aeae1/Rock-Saw-Water-Control/docs/hardware-audit-2026-10-04.md

# Electrical audit and revised schematic

Revision C · 4 October 2026 · **Engineering review complete; hardware release on hold**

[Printable schematic and audit](assets/hardware/water-controller-audit-rev-c.pdf) · [Connection schedule](../hardware/rev-c/connections.csv) · [Machine-readable netlist](../hardware/rev-c/netlist.json) · [Parts schedule](../hardware/rev-c/bom.csv)

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

## Release decision

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

## Corrections made

1. Replaced the unspecified four-channel input board with two documented SparkFun BOB-09118 two-channel boards, each operated with a **5 V output-side supply**. Each used input receives its own external 1 kohm series resistor; the board's original 220-ohm input resistor alone is inappropriate for a raw 12 V signal.
2. Separated the HSD boards' 12 V load terminals from their 5 V logic terminals. Documented the reversed orientation of their two supply connectors and the reversal between schematic OUT1..OUT8 names and printed channel 7..0 labels.
3. Specified one effective I2C pull-up pair: the DFR1229's onboard 4.7 kohm resistors. All six HSD pull-up jumpers remain open. The I2C bus runs at 100 kHz inside the enclosure.
4. Retained twenty independently switched lamp-positive leads. One PCA9685 cannot directly drive these twenty 12 V loads. Lamp negatives share the wired supply return.
5. Added a series resistor, filter capacitor and open-wire bias to the position ADC input. SEN0262 is an analog receiver, not an I2C peripheral; no parallel 250-ohm resistor is added to its input.
6. Explicitly showed that the DFR1229 output return and its logic ground are internally common. The selected non-isolated architecture therefore joins valve white and black at the system return, subject to H4.
7. Added a proposed valve inhibit branch on HSD3 channel 4, supervised by a local SW8B watchdog. A small relay disconnects both signal positives when actuator power is removed. The new relay regulator is separate from the Nano's 5 V rail.
8. Added two defined temperature sensors and reused HSD voltage/current measurements to support previously unspecified diagnostics. Actual thresholds remain subject to characterization.
9. Specified the meter's two pull-ups, both signal wires and actual pin assignments. Removed an assumed static error-level interpretation: the meter reports errors by toggling its error output.
10. Identified a command-driver error-reporting defect: the reviewed DFRobot library discards ordinary I2C write status. A checked driver is a release requirement.

## Exact design basis

| Reference | Part / specification | Role |
| :--- | :--- | :--- |
| U1 | Genuine Arduino Nano Every ABX00028 | 5 V controller; machine supply to VIN only |
| HSD1-3 | Serial Wombat PCB0046 HSD, public V2 | Twenty lamp channels; one supervised valve-power channel |
| U2 | DFRobot DFR1229 / GP8600 | 0-20 mA capable DAC, operated only in the 4-20 mA valve range |
| U3 | DFRobot SEN0262 | 0-25 mA to 0-3 V feedback receiver |
| O1, O2 | SparkFun BOB-09118, v1.2 circuit | Two channels each; three used |
| V1 | U.S. Solid USS-MSV50030 | 1/2-inch SS304, 9-24 V, five-wire proportional ball valve |
| FM1 | ScioSense UFM-02-03NP4 | 3/8-inch NPS, four-wire pulse variant; confirm exact order suffix |
| L1-10 | Nilight TL-248BW or electrically verified equivalent | Common black negative, separate blue and white 12 V positive leads |
| K1 | Panasonic TQ2-5V, single-side-stable, standard through-hole | DPDT signal disconnect; not a latching or MBB variant |
| U4 | ST L7805ABV, TO-220 | Dedicated relay-coil 5 V regulator; not connected to logic 5 V |
| TS1, TS2 | Analog Devices / Maxim DS18B20+, TO-92 | Enclosure and actuator-region temperature, externally powered |

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

## Power and grounding

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

The Nano Every uses an MPM3610 switching regulator. Its 5 V header supplies U2, U3, the three HSD logic VDD terminals, O1/O2 HV terminals, the meter, and the two temperature sensors. No lamp or actuator is powered from this rail. Measure total peripheral current and regulator temperature; the IC's headline current capability is not proof of the assembled board's enclosed capacity.

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

## G/H/J input circuit

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

## I2C and lamp drivers

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

## Valve command, feedback and inhibit

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

### Independent timeout proposal

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

## Flow meter

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

## Temperature circuit and enclosure

TS1 and TS2 are normal three-wire DS18B20 sensors: pin 1 GND, pin 2 DQ, pin 3 VDD. For the selected TO-92 package, the flat marked face points toward the observer and the leads point down. Both VDD pins receive 5 V. Both DQ pins share Nano D7 and R10 = 4.7 kohm to 5 V. C3/C6 = 100 nF go across each sensor's supply locally. Do not use parasite power. Record each sensor's unique ROM ID and location; identify a replacement deliberately instead of assigning locations by discovery order.

TS1 measures representative air inside the enclosure; TS2 measures the shaded actuator region. Neither measures the motor winding directly. Protect the external sensor termination in a sealed, strain-relieved probe assembly; bare TO-92 leads are not an outdoor connector. Bound cable length and validate the 1-Wire bus in the installed arrangement. Use CRC-checked reads and nonblocking conversion; a 12-bit conversion can take 750 ms. Reject uncompleted power-on readings, including the initial 85 C value; sensor loss must not look like a safe cold temperature.

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

## Diagnostic coverage and firmware requirements

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

**Avoid a recovery deadlock:** K1 deliberately disconnects feedback when valve power is inhibited. Zero feedback during that state is expected; it is not proof of a repaired or newly broken sensor. Before a recovery attempt, verify independently observable conditions (supply, bus, temperature, valid input states and corrected wiring/obstruction). Treat actuator-dependent checks as pending requalification, not already healthy. A fresh acknowledgement may authorize one supervised closing attempt with the DAC initialized to 4 mA before enabling power. Keep the fault history/latch until powered feedback, current and closure/flow checks pass. Apply characterized startup-settle and motion deadlines; a failed attempt immediately inhibits drive again and requires a new deliberate acknowledgement after correction. Do not wait for powered feedback before supplying its power, and do not clear the fault simply because power removal made its current zero. The simulator's injected-cause controls stand in for these physical checks; this sequence still needs firmware and hardware testing.

### Updated fault response policy (5 October)

The simulator and firmware contract now distinguish operator/settings faults (6, 7, 10) from movement-inhibiting faults (1–5, 8, 9). With independent actuator supervision healthy, operator faults retain valve power and issue a closed command while fault codes remain visible. A movement-inhibiting latch always wins, including after cause removal. Do not drop K1 solely because an operator code latched before the valve has closed; do drop the inhibit path on unsafe actuator conditions or watchdog expiry. Closing deadlines must survive new operator faults and acknowledgement without restarting. Reset makes no additional movement after confirmed closure, otherwise it authorizes/finishes bounded recovery and leaves water OFF. This policy changes software requirements only; the relay/sensor circuit remains unqualified and requires the bench checks described here.

### Does the Arduino log faults?

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

For the base hardware, use a bounded RAM event ring for detailed recent diagnostics, plus a small redundant EEPROM record for the most recent fault/reset summary. One possible allocation remains two 112-byte calibration/settings slots and two 16-byte diagnostic slots, totaling 256 bytes. A 16-byte diagnostic record can contain commit/schema bytes, a 16-bit sequence, 16-bit fault mask, 32-bit uptime, quantized target/position, mode/reset flags and CRC16. It cannot also hold a full curve, timestamps, voltage, current, temperature and many past events. This is a specification, not implemented storage code.

Record fault onset, added/cleared causes, acknowledgement, watchdog/brownout reset and calibration completion; coalesce repeated identical failures. Detailed RAM events should include code/subcode, uptime, raw controls, mode, requested target, measured position, supply, branch current, temperatures, flow validity and last bus error. Do not log every pulse or animation frame. Save only state changes with wear-aware transactional writes; retain the last valid record after an interrupted write. A sudden total power loss may prevent recording the final event, so report the next boot's reset cause as well.

No real-time clock is present. Records can contain uptime and sequence/boot context, but not reliable calendar dates while disconnected. A USB service command can export and inspect records later without clearing latches or moving the valve. Keep serial output nonblocking; a disconnected laptop must not stall control. For a substantial history that survives power removal, add a separately specified nonvolatile memory such as FRAM later. It is **not** included or wired in Revision C.

## Bench acceptance sequence

1. **Unpowered inspection:** match all SKUs/revisions and mark polarities. Check every scheduled wire, solder joint and net. Confirm no 12 V continuity to 5 V or signal nets; account for legitimate semiconductor paths. Check supply-to-ground resistance after capacitors settle. Verify K1 pin numbering/NO contacts and diode bands. Water and machine remain disconnected.
2. **Nano only:** use a current-limited nominal 12 V supply into VIN/GND; verify polarity and 5 V regulation. Check the actual board with USB absent, then service configuration separately. Set current limits for each connected stage using measured quiescent current, not a guessed final large limit.
3. **Logic modules:** add one module at a time. Verify 5 V load/current/temperature, seven I2C addresses, device identities, bus rise/low levels and default outputs. DFR output stays on the removable test load. All lamps and the valve remain disconnected initially.
4. **Inputs:** apply 0, 9, 12 and 16 V test signals separately through the completed resistor/opto circuits. Confirm D2/D3/D4 LOW/HIGH within logic limits and no channel cross-coupling. Hold every input during power-on/reset. Test G/H overlap and disconnected wires. Reverse-polarity qualification, if needed, is current-limited and separate from the Nano.
5. **DAC and receiver:** measure 4/12/20 mA commands with the test load. Independently test U3 with a known current source into I+/I-, verify SIGNAL and A0, then unplug SIGNAL to confirm the pull-down. Never put a multimeter in current mode directly across a voltage supply.
6. **Lamp outputs:** connect one lamp and identify both color leads. Test channels individually and confirm the table, including the V2 numbering reversal. Then test full patterns and thermal/current limits. Verify no pattern can energize HSD3 ch4-7. Default/reset condition must leave all lamp outputs and valve branch OFF.
7. **Inhibit, no valve:** use a safe dummy load on ch4. Verify U4 5 V, relay polarity/NO operation, 500 ms timeout proposal, latched timeout, no restart on a late feed, and actual power-off leakage. Test host reset, local SW8B reset, missing DAC, bus stuck-low and interruption between the two watchdog setup packets. Verify recovery can reach its powered requalification phase without requiring unavailable unpowered feedback, while never clearing a latch prematurely. Failure of any required response keeps H5 open.
8. **Valve interface, no pressurized water:** satisfy H4 before joining returns. Use a current-limited supply and correctly configured command source. Measure inrush, current, input burden and feedback voltage at several targets. Test close/open endpoints, signal disconnects and power loss. Determine whether feedback represents actual mechanical position during a jam; do not force or repeatedly stall the actuator.
9. **Meter and temperatures:** verify both sensor ROM IDs, CRC failures and unplugged-sensor behavior. Verify meter wire functions, zero/full-tube behavior, error toggling and counted volume against a measured collection. Confirm no lost pulses at the highest intended flow.
10. **Water and integration:** secure plumbing, provide the manual shutoff and test at low pressure first. Measure closure leak, motion time, repeatability, useful minimum opening, voltage range, full-pattern lamp current and enclosure hot soak. Inject faults by safe disconnections/test fixtures, not uncontrolled shorts. Validate power interruption during each storage phase and controls held during every reset path.
11. **Machine release:** resolve H1/H2, then repeat the relevant tests with the actual harness and running machine, secured attachment and safe water discharge. Record measured thresholds and acceptance evidence. Only then change the drawing status to construction/field release.

## Source register

All sources were reviewed on 4 October 2026. Manufacturer documents establish component facts; proposed combinations and calculated margins remain this project's engineering assumptions.

| ID | Primary source | Used for |
| :--- | :--- | :--- |
| S1 | [Nano Every datasheet](https://docs.arduino.cc/resources/datasheets/ABX00028-datasheet.pdf), [V4.0 schematic](https://docs.arduino.cc/resources/schematics/ABX00028-schematics.pdf), [pinout](https://docs.arduino.cc/resources/pinouts/ABX00028-full-pinout.pdf) | VIN, logic, pin labels, EEPROM, USB power path |
| S2 | [PCB0046 guide](https://www.serialwombat.com/p46), [V2 schematic](https://images.squarespace-cdn.com/content/v1/619ece9561f419760806a927/128caefe-64fd-4728-ba48-380cd703eb83/PCB_0046_V2_Schematic.png), [V2 drawing](https://images.squarespace-cdn.com/content/v1/619ece9561f419760806a927/7dcc598d-3537-4cc9-8b72-35188590463b/PCB_0046_V2_Drawing.png) | Terminals, power, channel mapping, pull-ups, diagnostics |
| S3 | [TI TPS4H160-Q1 datasheet](https://www.ti.com/lit/ds/symlink/tps4h160-q1.pdf) | Driver limits, current selection, leakage, fault behavior |
| S4 | [Serial Wombat Arduino library](https://github.com/BroadwellConsultingInc/SerialWombatArdLib), [device firmware](https://github.com/BroadwellConsultingInc/SerialWombat) | PWM setup, watchdog packets, timeout behavior; deployed image still to verify |
| S5 | [DFR1229 documentation](https://wiki.dfrobot.com/dfr1229/), [schematic](https://dfimg.dfrobot.com/wiki/23289/DFR1229_gp8600-dac-module_schematics_V1.0.pdf), [driver source](https://github.com/DFRobot/DFRobot_GP8XXX) | Current mode/scaling, boost stage, shared return, I2C error handling |
| S6 | [SEN0262 documentation](https://wiki.dfrobot.com/sen0262/), [schematic](https://dfimg.dfrobot.com/wiki/17563/SEN0262_current-to-voltage_schematics_v1.pdf) | Differential shunt, analog voltage, pin functions |
| S7 | [U.S. Solid Manual 11917 / 5003X](https://file.ussolid.com/content/JFMSV/Manual-5003X.pdf) | Valve wire colors, ratings, integrated actuator |
| S8 | [ScioSense UFM-02 datasheet, 8 June 2026](https://www.sciosense.com/wp-content/uploads/2026/06/SC-002732-DS-9-UFM-02-Datasheet.pdf) | Four-wire table, 5 V application, pull-ups, pulses, installation; pin-number prose discrepancy recorded |
| S9 | [SparkFun BOB-09118](https://www.sparkfun.com/sparkfun-opto-isolator-breakout.html), [v1.2 schematic](https://cdn.sparkfun.com/assets/d/e/4/5/e/Optoisolator-v12.pdf), [Eagle source](https://github.com/sparkfun/Opto_Isolator_Breakout), [Vishay ILD213T family](https://www.vishay.com/docs/83647/ild205t.pdf) | Exact input circuit and pin functions |
| S10 | [Panasonic TQ relay catalog](https://industry.panasonic.com/ac/cdn/e/control/relay/signal/catalog/mech_eng_tq.pdf), [ST L78 datasheet](https://www.st.com/resource/en/datasheet/l78.pdf) | Coil, contact numbering, regulator pins/thermal calculation |
| S11 | [DS18B20 datasheet](https://www.analog.com/media/en/technical-documentation/data-sheets/ds18b20.pdf) | Pins, supply, conversion time, CRC |
| S12 | [Skid Steer Genius technical reference](https://www.skidsteergenius.com/pages/technical) | Reproduced Takeuchi TL10V2/TL12V2/TL12R2 manual page 2-40; not proof of the individual harness |
| S13 | [Nilight TL-248BW](https://www.nilight.com/products/3-4inch-dual-color-marker-light-10pcs-blue-to-white-auxiliary-side-marker-bullet-clearance-indicator-lights-3-plug-connector-ip68-wa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) | Common negative and separate blue/white positives; load measurements still required |

## Verification performed here

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
