aeae1/Rock-Saw-Water-Control/docs/connections.md

# Conceptual Connections

Reviewed 2026-10-08 · Revision G functional overview

These diagrams show functions, not terminal-level construction wiring. G/H/J mean increase, decrease and trigger; they are not verified machine connector cavities. Use the [Revision G audit and detailed schematic](hardware-audit-rev-g.md) for terminal wiring, board configuration and release holds.

## Control and feedback

```mermaid
flowchart TD
    I["G / H / J: machine signals"] --> Q["Resistors and two opto boards"]
    Q --> C["Arduino Nano Every"]
    C -->|"Local I²C"| D["DFR1229 current command"]
    D -->|"Direct 4–20 mA command"| V["Integrated valve actuator"]
    V -->|"Direct 4–20 mA feedback"| R["SEN0262 receiver"]
    R -->|"Analog voltage to A0"| C
    C -->|"Local I²C"| H["Three PCB0046 HSD boards"]
    H -->|"20 switched 12 V color leads"| L["Ten blue/white lamps"]
```

The receiver uses an analog input. The proportional actuator includes its motor and controller; no external reversing H-bridge is involved. The HSD boards combine I/O expansion and high-side switching.

## Power distribution

| Source / branch | Loads and returns |
| :--- | :--- |
| Existing machine connector, verified 12 V | Nano VIN, HSD load inputs and valve RED |
| Connector wired ground | Power distribution return; separate load and analog-return routing |
| Nano 5 V rail, after load/thermal verification | HSD logic, DFR1229, SEN0262, input board HV |
| Twenty HSD switched outputs | One blue or white lamp-positive lead each |
| Lamp common negatives | Ground distribution, sized for combined current |
| HSD3 channels 4-7 | Unconnected; initialized OFF |

This reference installation uses the existing machine fuse and assumes clean nominal 12 V. No additional fuse block or separate source is included. Constant power does not identify key state. Fuse/wire coordination, key-off behavior and the internal watchdog recovery must be qualified before field use. Never power lamps or the valve through Nano GPIO or the 5 V logic rail.

## One lamp, repeated ten times

```mermaid
flowchart TD
    P["12 V load supply"] --> B["HSD blue channel"]
    P --> W["HSD white channel"]
    C["Local board control"] --> B
    C --> W
    B --> L["One blue/white lamp"]
    W --> L
    L --> G["Common negative return"]
```

Only one color is commanded at a time. Switch the old color off before enabling the new one. A remote lamp bar needs twenty switched leads plus its power return; placing the boards behind the bar keeps these wires short. Do not use machine-length bare I²C wiring.

## Water and machine installation

Garden-hose supply → manual shutoff → appropriate strainer → stainless valve → saw hose/manifold/nozzles. Support plumbing separately and use removable fittings and flexible sections. Match garden-hose and tapered NPT thread/seal types explicitly. The valve's single electrical cable exits the actuator box; there are no wires connected to the hose or stainless body.

Before assigning machine cavities, record voltage, polarity, connector viewing direction, G/H latch behavior and existing hydraulic wiring. Confirm that connecting this controller cannot energize an existing hydraulic function. [Skid Steer Genius technical resources](https://www.skidsteergenius.com/pages/technical) and its [help center](https://www.skidsteergenius.com/apps/help-center) are reference starting points; a generic fourteen-pin diagram is not a verified TL12R2 harness pinout.
