aeae1/Rock-Saw-Water-Control/docs/audit-2026-10-03.md

# Project Audit — 2026-10-03

Scope: simulator logic and browser inputs, startup and recovery, fault policy, tests, build/deployment, current hardware direction, pricing, wiring relationships, enclosure and firmware prerequisites. Only `aeae1/Rock-Saw-Water-Control` is in scope. No machine firmware was flashed, hardware purchased, or physical measurements performed.

## Assessment

The operator-interface design is coherent and the verified simulator defects below have been corrected. The project remains a **tested simulation and engineering plan**, not field-ready hardware. The largest remaining risks are how the real actuator responds to failed/stale signals, whether its feedback proves position, and how the selected boards behave during resets and heat. Software tests cannot close those questions.

## Verified fixes

| Finding | Correction | Regression evidence |
| :--- | :--- | :--- |
| G/H movement was ignored while unpowered, closing or faulted | Always track physical rocker state while separately inhibiting commands; consume blocked activations | Both directions before first power-on and during closure; release-order matrix |
| Simulator controls were disabled during states that needed held-input testing | Keep physical controls operable; expose command eligibility separately | Real browser startup/recovery scenarios plus deterministic checks |
| Neutral was accepted on a single event | Require 100 ms of continuous neutral after closure; any control activity restarts it | 99/100 ms boundary, repeated activity and no queued commands |
| Historical rocker-reset policy, superseded 5 October | Originally canceled acknowledgement on rocker movement; the current requested behavior allows holding/moving G/H during reset while consuming its setting commands | Current tests verify held G/H, movement during the three-second hold, and unchanged post-reset neutral qualification |
| A delayed J release could clear the watchdog before its overdue callback | Check powered elapsed duration before mode transition and release | Exact 30-second boundary, suspended callbacks and one-day delay |
| Unrelated capture loss or secondary mouse release could affect a J gesture | Match capture owner and primary-button release | Independent pointer and mouse-button tests |
| Build documents described obsolete parts and budgets | Reconcile current Nano/stainless/prebuilt-HSD design and label unresolved choices | Documentation review, link checks and current BOM |
| Assembly illustration remained unpublished after an interrupted upload | Add the concept image near the top of the README with its limitations | File-integrity and repository checks |

The original banner and supplied machine artwork are unchanged. The simulator link remains prominent. The new assembly image is conceptual: terminal details and cable routing are not verified wiring, and the illustrated temperature probe is a planned sensing function without a selected circuit.

## Verification evidence

| Check | Result during audit |
| :--- | :--- |
| Original baseline | 79 deterministic tests passed before changes |
| Updated behavior/startup suite | 117 tests passed locally |
| Expanded remapping/fault suite | 21 tests passed locally |
| Total deterministic coverage | 138 tests; individual suites passed locally |
| Remapping matrix | All 2,000 combinations of old cap, new cap, level and prior on/off state passed |
| Fault ordering | All 90 ordered distinct fault pairs passed |
| Retained coverage | 100 paused-marker cases, ten faults across three modes, 4,000 seeded stress actions |
| Browser suite | 42 cases configured; check the published commit's GitHub Actions result |
| Local browser execution | Not completed: browser archive download returned invalid/truncated content |
| Dependency audit | `npm audit` reported zero known vulnerabilities on the review date |
| Hardware acceptance | Not performed; no flashable controller firmware is supplied |

Run `npm ci` and `npm run check` for deterministic checks, build and local-document validation. Browser setup and commands are in the [README](../README.md#development). [GitHub Actions](https://github.com/aeae1/Rock-Saw-Water-Control/actions) records version-specific results and browser reports; a configured test is not a passing test until its run completes.

The new tests exercise the actual generated script. Expected remapping positions are selected from an independently enumerated set of allowable openings instead of copying the implementation's rounding expression. The deterministic harness can delay callbacks without advancing scheduled jobs, exposing gesture/watchdog ordering errors. Its normal power helper waits for the neutral qualification; startup tests deliberately bypass that convenience.

## Hardware findings requiring bench evidence

| Priority | Open item | What resolves it |
| :--- | :--- | :--- |
| Before field operation | **Constant hot is not ignition state.** Key-off may leave Normal or Flush active and lamps/valve drawing power. | Measure the actual feed and parked current. Define shutdown behavior explicitly; ignition sensing/master disconnect is not currently selected. |
| Before field operation | **Fault-stop circuitry is unfinished.** The simulator stops motion, but the proportional actuator may continue toward a stale target. | Establish and test an inhibit method with the Nano halted, DAC retained and bus disconnected. Do not rely on a display or software-only command. |
| Before field operation | **Power loss is not demonstrated closure.** Product-page generic normally-closed language is insufficient proof. | Test the supplied model from several openings, including short powered intervals. Retain an upstream manual shutoff. |
| Before field operation | **Feedback may not prove mechanical closure under every failure.** | Compare feedback with actual ball/shaft movement and water shutoff, including obstruction/no-progress cases. |
| Before field operation | **Set Max requires hold-at-current-position.** Exact feedback/command latency and deadband are unknown. | Interrupt motion, command the measured position and quantify drift/settling under hose pressure. |
| Before construction release | **Current-loop compatibility and common returns need confirmation.** | Verify DFR1229 4/12/20 mA into the valve, required compliance, SEN0262 scaling and black/white return relationships. |
| Before construction release | **Some diagnostic sensors are absent.** | Select and wire actual actuator-current, voltage and temperature acquisition; implement thresholds and hysteresis from measurements. |
| Before construction release | **HSD bank limits, boot states and installed firmware require testing.** | Measure lamp color loads, scan all six addresses, test MCU-only/board-only resets, configure diagnostics and prove bounded bus handling. |
| Before outdoor use | **Ingress rating does not prove hot-sun or vibration suitability.** Valve ambient limit is 50°C. | Scale enclosure layout, shade/strain relief, hot-soak measurements and protected valve mounting. Keep the first build serviceable. |
| Before pin-level wiring | **No machine cavity map has been released.** | Verify exact harness documentation, connector viewing direction, input polarity/voltage and hydraulic independence on the fitted machine. |
| Before budget approval | **Complete cost is unknown.** | Confirm all three HSD-board prices and availability, input module, housings, harness materials and unfinished sensing/inhibit parts. |

Sources and current wiring relationships are linked in the [build guide](build-guide.md), [hardware register](hardware.md) and [fault contract](faults.md). No new fuse block or separate supply has been added; the reference installation uses its existing connector feed and machine fuse under the clean-supply assumption specified for the project.

## Corrections to earlier simplification claims

Ten independent blue/white lamps require twenty color-power channels. One sixteen-channel PCA9685 cannot directly supply those twenty 12 V leads. Three PCB0046 high-side boards remain the current prebuilt direction; their cost is still unverified. SEN0262 is an analog receiver, not another I²C device. Its nominal 4–20 mA feedback voltage is 0.48–2.40 V. A shunt-only replacement is possible in a separately designed receiver, but adding a shunt in parallel with the existing receiver is not the selected circuit.

The wired proportional valve includes its own motor/controller and eliminates the proposed Tuya reverse-engineering path. It does not eliminate the current-command interface or position receiver. The four currently priced core items total $138.99; that is not a complete build. With the historical $25.99 lamp example, only $35.02 remains under $200 for everything else, so this prebuilt design has not demonstrated a sub-$200 total.

## Firmware and calibration handoff

The [firmware contract](../firmware/README.md) now records raw input acquisition, neutral qualification, reset precedence, bounded bus calls, explicit 4 mA startup, stale-output handling, a finite memory budget and unsigned timer rollover. The Nano Every has only 256 bytes of EEPROM; redundant calibration/settings and fault records must be designed to fit. MCU timing, storage endurance, actual watchdog behavior and compiled RAM use have not been tested by the browser suite.

The [flow curve plan](flow-calibration.md) remains unchanged in principle: measure through the actual hose/nozzles, use a validated monotone table and choose the nearest physical target on cap changes. Opening percentage and calibrated-flow percentage must remain separately labeled. Position feedback alone cannot diagnose a dry supply, blocked nozzle or hose leak. No invented calibration curve or measured-GPM claim has been added.

Next implementation work should begin with the bench acceptance sequence in the [build guide](build-guide.md) and record the measurements using [Validation](validation.md). Release firmware and final terminal-level wiring only after those results establish the electrical and actuator behavior.
