aeae1/Rock-Saw-Water-Control/docs/assets/hardware/water-controller-single-page-rev-g.pdf

# ROCK-SAW WATER CONTROL

CONTINUOUS WIRING REFERENCE / REVISION G / 8 OCTOBER 2026

## ONE CONNECTED DRAWING · 102 WIRES

A0 landscape · vector PDF · keep the detailed booklet

Read by terminal name, not by physical pin position.
Solid dot = joined wires. Gapped crossing = no connection. W-numbers match the connection register.

## BENCH DESIGN — H1–H5 QUALIFICATION STILL REQUIRED

Incoming labels are signal names, NOT machine connector cavity numbers.

## U1 ARDUINO

Nano Every · ABX00028

A4 / A5: local I²C bus
A0: valve position
D7 / D8 / D9: unused

No flow or temperature sensors USB: programming / service

U2 CURRENT COMMAND

DFRobot DFR1229

0x58 · 4–20 mA

### U3 POSITION RECEIVER

DFRobot SEN0262

4–20 mA → analog voltage
No extra 250 Ω shunt

## HSD1 HIGH-SIDE DRIVER

Serial Wombat PCB0046 HSD V2

I²C 0x60 / 0x61 · 12 V lamp outputs
V = logic 5 V; G = G0…G7 = LOAD_GND internally

## HSD2 HIGH-SIDE DRIVER

Serial Wombat PCB0046 HSD V2

I²C 0x62 / 0x63 · 12 V lamp outputs
V = logic 5 V; G = G0…G7 = LOAD_GND internally

## HSD3 HIGH-SIDE DRIVER

Serial Wombat PCB0046 HSD V2

I²C 0x64 / 0x65 · 12 V lamp outputs
V = logic 5 V; G = G0…G7 = LOAD_GND internally

CH4–CH7: unused / off

O1 INPUTS G / H

BOB-09118 v1.2

JP2_1: no connection

### O2 INPUT J

BOB-09118 v1.2

OUT2, JP2_1: unused

V1 VALVE + ACTUATOR

U.S. Solid USS-MSV50030
½-inch stainless · 9–24 V
Five-wire actuator cable

GREEN: command +
WHITE: signal common
YELLOW: feedback +

Shared machine power; no power cut

L1

12 V · TL-248BW

L2

12 V · TL-248BW

L3

12 V · TL-248BW

L4

12 V · TL-248BW

L5

12 V · TL-248BW

L6

12 V · TL-248BW

L7

12 V · TL-248BW

L8

12 V · TL-248BW

L9

12 V · TL-248BW

L10

12 V · TL-248BW

R1
1 kΩ / 0.5 W

K

A

D1
R2 | 1N4148
1 kΩ / 0.5 W

K

A

D2
1N4148
R3
1 kΩ / 0.5 W

K

A

D3
1N4148

R4
1 kΩ

R5
100 kΩ

C1
100 nF

C10
100 nF

C11
100 nF

C12

100 nF

+ C7

47 µF / 35 V

+ C8

47 µF / 35 V

+ C9

47 µF

### 12 V

### 0 V

J

H

G

BLUE | WHITE | BLACK | BLUE | WHITE | BLACK | BLUE | WHITE | BLACK | BLUE | WHITE | BLACK | BLUE | WHITE | BLACK | BLUE | WHITE | BLACK | BLUE | WHITE | BLACK | BLUE | WHITE | BLACK | BLUE | WHITE | BLACK | BLUE | WHITE | BLACK
CH0 | CH1 | CH2 | CH3 | CH4 | CH5 | CH6 | CH7
VIN | 0 V | V / 5 V | D / SDA | C / SCL
CH0 | CH1 | CH2 | CH3 | CH4 | CH5 | CH6 | CH7
VIN | 0 V | V / 5 V | D / SDA | C / SCL
CH0 | CH1 | CH2 | CH3
VIN | 0 V | V / 5 V | D / SDA | C / SCL
IN GND | HV | HV GND
IN GND | HV | HV GND

IN1

IN2

OUT1

OUT2

IN1

IN2

OUT1

VIN | 5V | GND | A4 | A5

D2

D3

D4

A0

VCC | GND | I-

SIGNAL

I+

VCC GND

SDA

SCL | OUT
RED | BLACK | WHITE

GREEN

YELLOW

W001

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
W006

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
W015

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
W030

W032

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
W036

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
W040 | W042 | W041

W043

W044

W045 | W047 | W046

W048

W049

W050 | W052 | W051

W053

W054

W055

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
W095
W097
W100 | W099

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
W115 W116

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
W119 W120

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
W123 W124

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
TB12 MACHINE +12 V

TB5 REGULATED +5 V

TB0 COMMON RETURN / 0 V

LAMP RETURNS — size for the sum of active lamp currents

SDA
SCL

### NANO INTERNAL WATCHDOG ONLY

No external reset parts or valve-power switch.

HSD3 CH4–CH7 remain unused and OFF.

## CONTROL WITHOUT A FLOW METER

Valve power shares the machine supply; signal loops are direct. Normal, Set Max, Flush and all ten lamps retain their controls.
An optional bucket / stopwatch calibration can map levels to flow.
A stored curve estimates flow only under similar water conditions.
No automatic flow sweep, live GPM or water-stop detection is provided.
The internal watchdog can recover the Nano; power loss does not close the valve. Live G/H/J with main power OFF: opto inputs draw about 9 mA each at 12 V. Output-side HV = controller logic 5 V only. Bench-check the power-off case.

## BUILD AND READING NOTES

- All 102 external wires are drawn. Shared trunks are joined terminals, not additional electronics.
- Component terminal positions are arranged for readability. Use the detailed sheets for physical pinouts.
- U1 GND1 = GND2; RESET headers unused; U2 GND = OUT_GND; HSD grounds are internally common.
- I²C stays inside the enclosure below 100 kHz. Use only the U2 SDA/SCL pull-ups; open all HSD bus pull-up jumpers.
- HSD1 address jumpers open; HSD2 A1 closed; HSD3 A2 closed. All MAX_AMP jumpers open.
- HSD3 CH4–CH7 are unused and must remain OFF. Only twenty mapped channels drive lamps.
- Resistors: 1%. Ceramic capacitors: X7R, 50 V. C7–C9: 47 µF, 35 V, 105 °C; observe polarity.
- Unused Nano pins: 3V3, A1/A2/A3/A6/A7, AREF, RX/TX, D5/D6/D7/D8/D9/D10/D11/D12/D13.
- No relay, coil regulator, flow meter or temperature probes. Codes 2 / 9 have no fitted sensors.
- Plumbing: hose → shutoff / strainer → valve → sprayer. Support the plumbing and keep electrical wiring dry.

Power loss does not spring-return the ball valve closed. Keep an accessible manual water shutoff.

RELEASE HOLDS | H1 actual machine cavities · H2 fuse / wire sizing · H3 purchased parts · H4 valve signal returns / compliance · H5 firmware and bench qualification
38 components · 38 nets · no flow / temperature sensors · detailed circuit booklet and connection register remain companion documents | SHEET 1 OF 1
