aeae1/Rock-Saw-Water-Control/docs/assets/hardware/water-controller-audit-rev-c.pdf

REV C | BENCH DESIGN - RELEASE HOLDS H1-H5 | Audit / 1

# Electrical audit and revised schematic

Revision C · 4 October 2026 · Engineering review complete; hardware release on hold

Printable schematic and audit (https://github.com/aeae1/Rock-Saw-Water-Control/blob/main/docs/assets/hardware/water-controller-audit-rev-c.pdf) · Connection schedule (https://github.com/aeae1/Rock-Saw-Water-Control/blob/main/docs/../hardware/rev-c/connections.csv) · Machine-readable netlist (https://github.com/aeae1/Rock-Saw-Water-Control/blob/main/docs/../hardware/rev-c/netlist.json) · Parts schedule (https://github.com/aeae1/Rock-Saw-Water-Control/blob/main/docs/../hardware/rev-c/bom.csv)

This revision supersedes earlier conceptual wiring illustrations for construction purposes. It describes the selected Nano Every, proportional valve, twenty lamp outputs, and four-wire ultrasonic flow meter. It includes a proposed independent valve-power watchdog and signal-disconnect relay. It is a complete connection specification for a controlled bench prototype, not permission to connect an unverified harness to a machine. There is no flashable controller firmware in this repository.

The drawings use functional terminal labels. A repeated net name is an electrical connection, even when the wire continues on another sheet. A crossing without a dot is not a junction. Component boxes are not physical footprints. Connector viewing direction and actual board markings take precedence over the apparent position of terminals in a functional drawing.

## Release decision

The earlier drawing should not be used as a soldering guide. The following physical evidence is still required; software simulation cannot supply it.

Hold point | Evidence required before machine connection
H1 - Machine harness | Connector face and wire-side photographs; cavity identification; measured supply, ground, and G/H/J states, including ignition off and engine running. The manual's ACC label does not prove a constant battery connection.
H2 - Existing fuse and wiring | Actual fuse rating, supply/return wire sizes, cable lengths, total attachment load, and coordination with every downstream conductor. A machine fuse does not automatically protect smaller added wires. No extra fuse block is drawn, as requested. If the existing protection is unsuitable, this arrangement cannot be released unchanged.
H3 - Actual purchased boards | Part numbers, revisions and photographs matching this schedule; exact lamp wire functions/current; HSD boot behavior and watchdog-mode availability on the installed SW8B image. A visually similar module is not an interchangeable part.
H4 - Valve electrical interface | Manufacturer confirmation or controlled measurements establishing shared black/white return compatibility, command input burden/compliance, feedback operation into 120 ohms, startup and signal-loss behavior, and motor inrush/running current.
H5 - Firmware and bench qualification | Checked bus driver, watchdog/inhibit tests, closure feedback, calibrated ADC/current readings, fault handling, power-interruption storage tests, input tests, enclosure thermal test and actual water tests. None is established by browser tests.

Do not bridge an uncertain valve signal return, guess a machine cavity, or apply machine power simply because the diagram looks complete. Verified passive/interface subassemblies can be assembled and continuity-tested separately. First powered tests use a current-limited bench supply with the valve and water isolated.

## Corrections made

1. Replaced the unspecified four-channel input board with two documented SparkFun BOB-09118 two-channel boards, each operated with a 5 V output-side supply. Each used input receives its own external 1 kohm series resistor; the board's original 220-ohm input resistor alone is inappropriate for a raw 12 V signal.
2. Separated the HSD boards' 12 V load terminals from their 5 V logic terminals. Documented the reversed orientation of their two supply connectors and the reversal between schematic OUT1..OUT8 names and printed channel 7..0 labels.

## ROCK-SAW WATER CONTROL / REVISED ELECTRICAL OVERVIEW

Detailed terminal circuits: sheets 01-06. Every external wire is listed in connections.csv.

REV C | 04 OCT 2026 | BENCH DESIGN - H1-H5 HOLD | Named nets connect across sheets

Solid dot = joined wires. Crossing without a dot = no connection. Boxes show functions, not physical footprints.

Reused machine connector

12 V + wired return + G/H/J

Arduino Nano Every

VIN -> 5 V logic; controls + sensing

Three PCB0046 HSD boards

20 lamp channels + valve watchdog

Two BOB-09118 input boards

3 x 1k resistors + reverse diodes

DFR1229 + SEN0262

Command current / position feedback

U4 + K1 / valve inhibit

Switched actuator power + signal relay

Flow meter + temperatures

5 V pulse / error / 1-Wire

V1 / stainless ball valve

One five-wire actuator cable

12 V / 0V | 5 V / I2C / 0V

G/H/J

D2/3/4

I2C / A0

5 V / 0V

HSD3 ch4

4-20 mA

Power +
signals

D8 flow / D9 error / D7 temperature

Plumbing: manual shutoff -> meter -> straight section -> valve -> saw sprayer. No electrical wires to hose or valve body.

OVERVIEW ONLY: grouped links represent multiple conductors. Use the detailed circuit sheets to assemble.

## 01 / POWER AND LOCAL BUS

Supply domains, module grounds, I2C addresses and Nano connections

REV C | 04 OCT 2026 | BENCH DESIGN - H1-H5 HOLD | Named nets connect across sheets

Solid dot = joined wires. Crossing without a dot = no connection. Boxes show functions, not physical footprints.

X1 / reused connector

INTERNAL terminal labels only
X1.1 | MACHINE_12V
X1.2 | 0V

X1.3 = G; X1.4 = H; X1.5 = J. Actual machine cavities: H1 HOLD. No additional fuse block; H2 HOLD.

U1 / Nano Every

Only VIN accepts machine voltage
U1.VIN | MACHINE_12V
U1.GND1 | 0V
U1.5V | LOGIC_5V
U1.A4 | SDA
U1.A5 | SCL

PARALLEL SUPPLY CONNECTIONS

MACHINE_12V -> TB12 -> U1 VIN + HSD1/2/3 VIN 0V -> TB0 -> all power/signal returns
LOGIC_5V -> TB5 -> U2 VCC, U3 VCC, HSD V, O1/O2 HV, FM1 RED, TS1/TS2 pin 3

HSD load GND also grounds its logic internally. Do not carry lamp current through a logic header. U2 OUT_GND = U2 GND internally.
U1 GND2 = U1 GND1 internally.
U4 relay 5 V must NOT connect to LOGIC_5V.

LOCAL I2C - 100 kHz

SDA: U1 A4 -> U2 SDA + HSD1/2/3 D
SCL: U1 A5 -> U2 SCL + HSD1/2/3 C
U2: 0x58; HSD pairs: 0x60/61, 0x62/63, 0x64/65 Use U2 onboard 4.7k pull-ups only.
Open all HSD SDA/SCL pull-up jumpers.
All bus wiring remains inside enclosure.

Local HSD bypass at each VIN/GND: 47 uF / 35 V (+ to VIN) in parallel with 100 nF / 50 V. USB can energize the logic rail. Disconnect machine, valve and water before USB servicing.

## 02 / G, H AND J INPUTS

SparkFun BOB-09118 v1.2: HV terminal receives 5 V, not machine voltage

REV C | 04 OCT 2026 | BENCH DESIGN - H1-H5 HOLD | Named nets connect across sheets

Solid dot = joined wires. Crossing without a dot = no connection. Boxes show functions, not physical footprints.

G / X1.3

Machine signal | R1 1k / 0.5 W | O1 channel 1

Internal 220-ohm resistor + optocoupler + inverter

O1.IN1

O1.OUT1 | U1.D2
D1 1N4148 | K/band to IN
H / X1.4 | A to 0V
Machine signal | R2 1k / 0.5 W | O1 channel 2

Internal 220-ohm resistor + optocoupler + inverter

O1.IN2

O1.OUT2 | U1.D3
D2 1N4148 | K/band to IN
J / X1.5 | A to 0V
Machine signal | R3 1k / 0.5 W | O2 channel 1

Internal 220-ohm resistor + optocoupler + inverter

O2.IN1

O2.OUT1 | U1.D4
D3 1N4148 | K/band to IN

A to 0V

O1/O2 HV -> LOGIC_5V; HV-GND and INPUT_GND -> 0V. O2 IN2 -> INPUT_GND.
O2 OUT2 and both JP2 pin 1 pads unused. HIGH machine input -> HIGH Arduino input. The three diodes are across the input LED circuits, after the external series resistors.

## 03 / VALVE POWER AND SIGNAL DISCONNECT

K1 normally-open contacts prevent command/feedback backfeed when the actuator is unpowered

HSD3 printed CH4 (+); VALVE_12V; U4 / L7805ABV; TO-220: 1 IN, 2 GND, 3 OUT; RELAY_5V; Single-side-stable, DPDT; K1.1 coil +; K1.10 coil -; C4 330 nF: U4 pin 1 -> pin 2; C5 100 nF: U4 pin 3 -> pin 2; D4 1N4148 across coil:; K/band -> K1.1; A -> K1.10; V1 / actuator; One five-wire cable; RED; U2 OUT; K1.3 COM; GREEN; K1.8 COM; YELLOW; V1.BLACK; 0V / H4 HOLD; V1.WHITE

REV C | 04 OCT 2026 | BENCH DESIGN - H1-H5 HOLD | Named nets connect across sheets

Solid dot = joined wires. Crossing without a dot = no connection. Boxes show functions, not physical footprints.

Tab = GND; do not join U4 OUT to Nano 5 V.

See bottom-view relay pin map in schedule.

K1 coil de-energized: 3-4 OPEN and 8-7 OPEN. K1 pins 2, 5, 6, 9 are unused.
U2 OUT_GND and U3 I- -> valve white/common -> 0V (return compatibility requires H4). Proposed watchdog: 500 ms timeout; latch LOW until deliberate closed-command recovery. Removing power can leave the ball open. Upstream manual water shutoff remains necessary.

## 04 / ANALOG POSITION AND FLOW METER

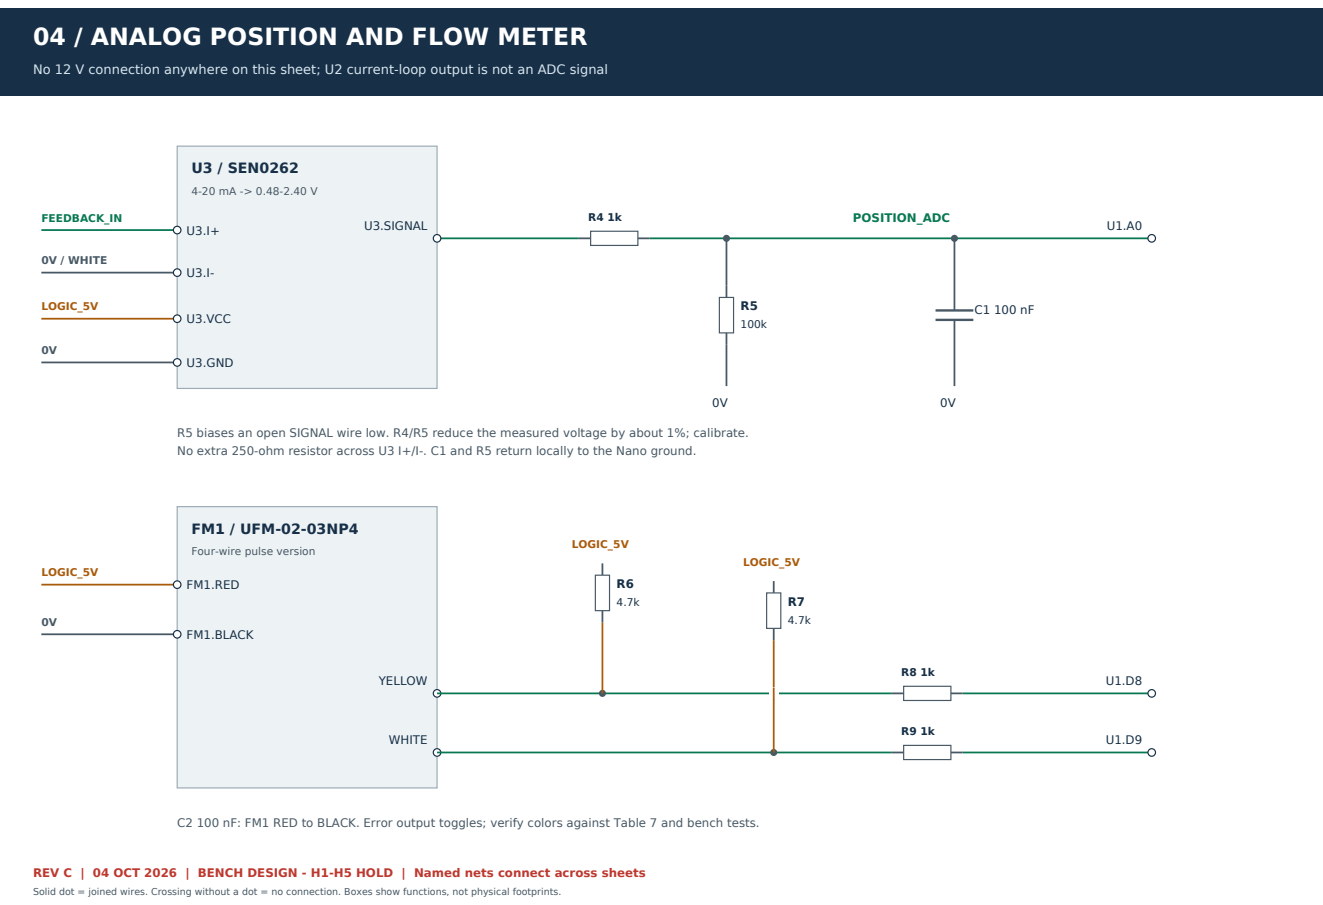
[picture p15: page 6]

No 12 V connection anywhere on this sheet; U2 current-loop output is not an ADC signal

R5 biases an open SIGNAL wire low. R4/R5 reduce the measured voltage by about 1%; calibrate.
No extra 250-ohm resistor across U3 I+/I-. C1 and R5 return locally to the Nano ground.

Four-wire pulse version

C2 100 nF: FM1 RED to BLACK. Error output toggles; verify colors against Table 7 and bench tests.

REV C | 04 OCT 2026 | BENCH DESIGN - H1-H5 HOLD | Named nets connect across sheets

Solid dot = joined wires. Crossing without a dot = no connection. Boxes show functions, not physical footprints.

## 05 / LAMP OUTPUTS AND BOARD CONFIGURATION

Use the printed channel numbers. Each blue/white lamp needs TWO separate switched positives.

REV C | 04 OCT 2026 | BENCH DESIGN - H1-H5 HOLD | Named nets connect across sheets

Solid dot = joined wires. Crossing without a dot = no connection. Boxes show functions, not physical footprints.

HSD1 / PCB0046 V2

0x60/61 | LOAD VIN 12 V; VDD 5 V
CH0 | L1 BLUE +
CH1 | L1 WHITE +
CH2 | L2 BLUE +
CH3 | L2 WHITE +
CH4 | L3 BLUE +
CH5 | L3 WHITE +
CH6 | L4 BLUE +
CH7 | L4 WHITE +

VIN -> MACHINE_12V; LOAD GND -> 0V D -> SDA; C -> SCL; V -> LOGIC_5V All lamp BLACK leads -> rated 0V return

HSD2 / PCB0046 V2

0x62/63 | LOAD VIN 12 V; VDD 5 V
CH0 | L5 BLUE +
CH1 | L5 WHITE +
CH2 | L6 BLUE +
CH3 | L6 WHITE +
CH4 | L7 BLUE +
CH5 | L7 WHITE +
CH6 | L8 BLUE +
CH7 | L8 WHITE +

VIN -> MACHINE_12V; LOAD GND -> 0V D -> SDA; C -> SCL; V -> LOGIC_5V All lamp BLACK leads -> rated 0V return

HSD3 / PCB0046 V2

0x64/65 | LOAD VIN 12 V; VDD 5 V
CH0 | L9 BLUE +
CH1 | L9 WHITE +
CH2 | L10 BLUE +
CH3 | L10 WHITE +
CH4 | VALVE_12V / WATCHDOG
CH5 | UNUSED / OFF
CH6 | UNUSED / OFF
CH7 | UNUSED / OFF

VIN -> MACHINE_12V; LOAD GND -> 0V D -> SDA; C -> SCL; V -> LOGIC_5V All lamp BLACK leads -> rated 0V return

All HSD SDA/SCL pull-up jumpers OPEN. Address: HSD1 all open; HSD2 A1 closed; HSD3 A2 closed. V2 component-side: printed ch7 at top, ch0 at bottom; schematic OUT1 = ch7, OUT8 = ch0.
Top supply: VIN left / G right. Bottom supply: G left / VIN right. Verify markings before power.

## 06 / TEMPERATURE AND TERMINAL ORIENTATION

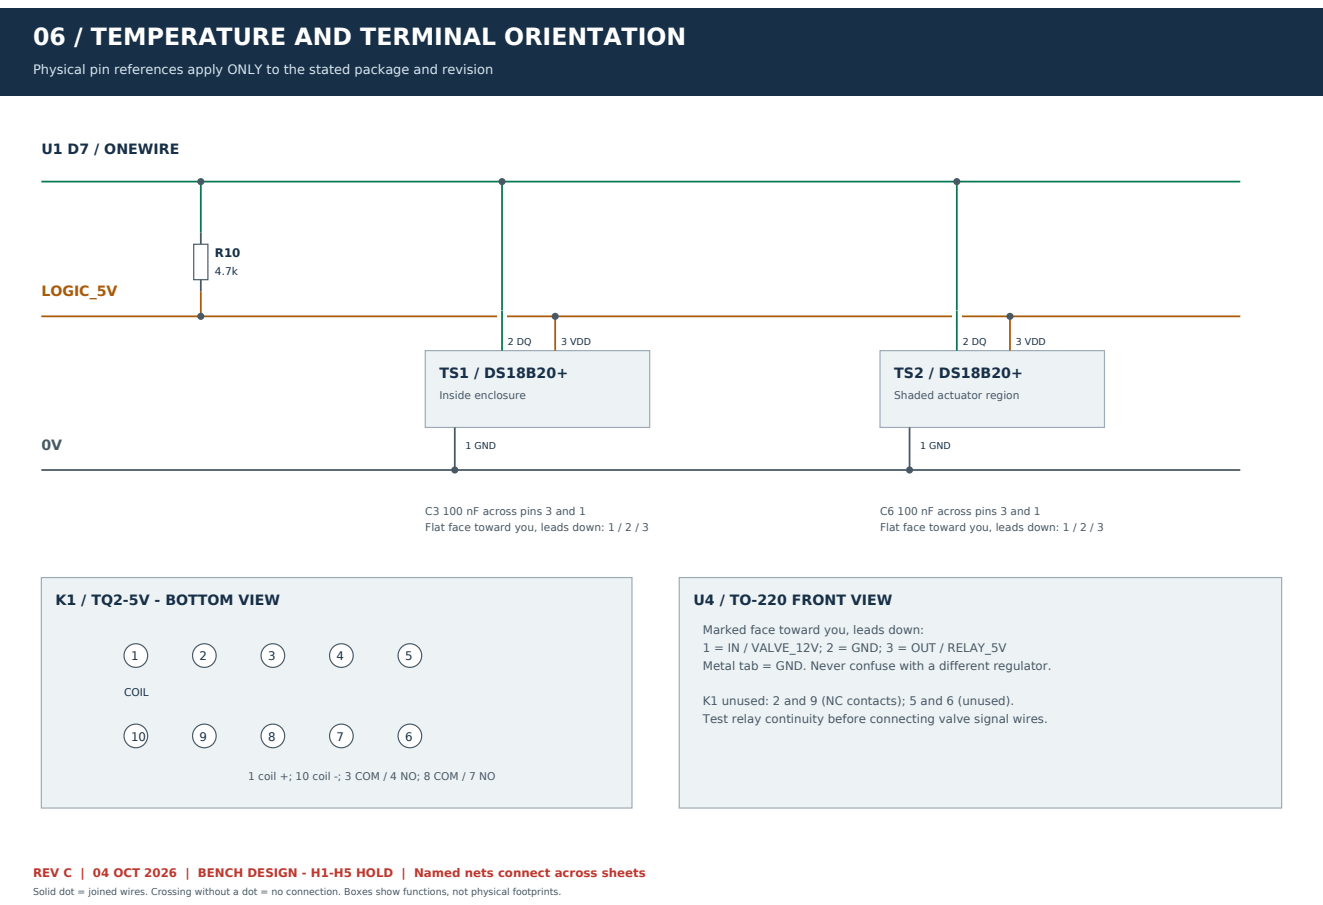
[picture p16: page 8]
U1 D7 / ONEWIRE; LOGIC_5V; Inside enclosure; 1 GND; 3 VDD; K1 / TQ2-5V - BOTTOM VIEW; COIL

Physical pin references apply ONLY to the stated package and revision

Shaded actuator region

C3 100 nF across pins 3 and 1
Flat face toward you, leads down: 1 / 2 / 3

C6 100 nF across pins 3 and 1

U4 / TO-220 FRONT VIEW

Marked face toward you, leads down:
1 = IN / VALVE_12V; 2 = GND; 3 = OUT / RELAY_5V
Metal tab = GND. Never confuse with a different regulator.

K1 unused: 2 and 9 (NC contacts); 5 and 6 (unused).
Test relay continuity before connecting valve signal wires.

1 coil +; 10 coil -; 3 COM / 4 NO; 8 COM / 7 NO

REV C | 04 OCT 2026 | BENCH DESIGN - H1-H5 HOLD | Named nets connect across sheets

Solid dot = joined wires. Crossing without a dot = no connection. Boxes show functions, not physical footprints.

3. Specified one effective I2C pull-up pair: the DFR1229's onboard 4.7 kohm resistors. All six HSD pull-up jumpers remain open. The I2C bus runs at 100 kHz inside the enclosure.
4. Retained twenty independently switched lamp-positive leads. One PCA9685 cannot directly drive these twenty 12 V loads. Lamp negatives share the wired supply return.
5. Added a series resistor, filter capacitor and open-wire bias to the position ADC input. SEN0262 is an analog receiver, not an I2C peripheral; no parallel 250-ohm resistor is added to its input.
6. Explicitly showed that the DFR1229 output return and its logic ground are internally common. The selected non-isolated architecture therefore joins valve white and black at the system return, subject to H4.
7. Added a proposed valve inhibit branch on HSD3 channel 4, supervised by a local SW8B watchdog. A small relay disconnects both signal positives when actuator power is removed. The new relay regulator is separate from the Nano's 5 V rail.
8. Added two defined temperature sensors and reused HSD voltage/current measurements to support previously unspecified diagnostics. Actual thresholds remain subject to characterization.
9. Specified the meter's two pull-ups, both signal wires and actual pin assignments. Removed an assumed static error-level interpretation: the meter reports errors by toggling its error output.
10. Identified a command-driver error-reporting defect: the reviewed DFRobot library discards ordinary I2C write status. A checked driver is a release requirement.

## Exact design basis

Reference | Part / specification | Role
U1 | Genuine Arduino Nano Every ABX00028 | 5 V controller; machine supply to VIN only
HSD1-3 | Serial Wombat PCB0046 HSD, public V2 | Twenty lamp channels; one supervised valve-power channel
U2 | DFRobot DFR1229 / GP8600 | 0-20 mA capable DAC, operated only in the 4-20 mA valve range
U3 | DFRobot SEN0262 | 0-25 mA to 0-3 V feedback receiver
O1, O2 | SparkFun BOB-09118, v1.2 circuit | Two channels each; three used
V1 | U.S. Solid USS-MSV50030 | 1/2-inch SS304, 9-24 V, five-wire proportional ball valve
FM1 | ScioSense UFM-02-03NP4 | 3/8-inch NPS, four-wire pulse variant; confirm exact order suffix
L1-10 | Nilight TL-248BW or electrically verified equivalent | Common black negative, separate blue and white 12 V positive leads
K1 | Panasonic TQ2-5V, single-side-stable, standard through-hole | DPDT signal disconnect; not a latching or MBB variant
U4 | ST L7805ABV, TO-220 | Dedicated relay-coil 5 V regulator; not connected to logic 5 V
TS1, TS2 | Analog Devices / Maxim DS18B20+, TO-92 | Enclosure and actuator-region temperature, externally powered

The proportional actuator already includes its motor, gearbox and controller. Its only electrical connections are the five wires leaving the actuator housing. Neither the valve body nor either hose receives an electrical wire.

## Power and grounding

The reused connector supplies MACHINE_12V and 0V. The input-interface calculations use a 9-16 V test envelope, pending H1/H4; it is not a released whole-system operating range or a qualified vehicle transient range. U1 VIN and all three HSD load VIN terminals connect to this supply in parallel. The actuator must receive at least 9 V at its own red/black leads under load. A 9 V connector supply cannot guarantee that after HSD and cable voltage drops; the eventual low-voltage cutoff must include measured drop and margin. Load wiring returns to the distribution point, not through a Nano header or thin logic-ground wire. Do not use the chassis as the sole return.

The Nano Every uses an MPM3610 switching regulator. Its 5 V header supplies U2, U3, the three HSD logic VDD terminals, O1/O2 HV terminals, the meter, and the two temperature sensors. No lamp or actuator is powered from this rail. Measure total peripheral current and regulator temperature; the IC's headline current capability is not proof of the assembled board's enclosed capacity.

At each HSD load input, add one local 47 uF, 35 V, 105 C electrolytic capacitor in parallel with a 100 nF, 50 V X7R capacitor. C7/C10 serve HSD1, C8/C11 HSD2, and C9/C12 HSD3. Electrolytic positive goes to VIN and negative to LOAD_GND. These provide local bypassing; they do not make the assembly a qualified automotive transient-protection circuit.

Each HSD already joins its load GND and logic GND internally. Use its rated load-ground connection to the main return. The duplicate D/C/V/G header's G pad need not have a second thin return wire; do not route lamp return current through it. The netlist records this internal common explicitly. Other module grounds and valve white use short dedicated returns to the distribution point, separate from the actuator-black and lamp-current paths until that point.

U4 powers only the relay coil. Its input comes from VALVE_12V, not constant supply. TO-220, text facing the observer and leads downward: pin 1 IN, pin 2 GND, pin 3 OUT; metal tab is GND. Place C4 = 330 nF between IN/GND and C5 = 100 nF between OUT/GND near its leads. The external parts schedule uses 50 V X7R capacitors. D4, a 1N4148 across the relay coil, has its band/cathode toward coil positive.

The official Nano V4.0 schematic shows USB VBUS feeding the 5 V rail through a Schottky diode. USB can therefore energize the DAC and peripherals with machine power absent. Service with the machine connector unplugged, the valve disconnected, and the water isolated. Do not assume unplugging the 12 V lead makes the electronics electrically dead while USB is attached. Do not connect a second regulated 5 V supply to the rail.

Constant supply also means constant parked draw. Normal water OFF does not disconnect controller power. Whether a key cycle actually causes a reboot depends on H1. If the supply truly remains live, isolate the controller using an appropriate existing disconnect when stored; a new master-switch design is not hidden in this schematic.

Final wire gauges, connector current ratings, distribution hardware and enclosure size are deliberately not guessed before H2 and actual dimensions. Use locking, polarized connectors and strain relief; do not use loose breadboard/Dupont jumpers on the attachment. Labels X1.1..X1.5 are new internal harness terminal names, not machine connector cavity numbers.

## G/H/J input circuit

For each signal, the machine line passes through R1/R2/R3 = 1 kohm, 1%, 0.5 W before the selected opto-board IN terminal. D1/D2/D3 is a 1N4148 from input return to that IN terminal: anode at return, band/cathode at IN. It limits reverse voltage across the optocoupler LED. Both input return and output-side HV-GND ultimately connect to system 0V; this design uses optocouplers for signal translation and buffering, not whole-system galvanic isolation.

O1 IN1 = G, O1 IN2 = H, O2 IN1 = J. O2 IN2 is tied to input return; O2 OUT2 is unused. On both boards HV means the output-side supply and connects to regulated 5 V here. It must not connect to 12 V. O1 OUT1/OUT2 go to D2/D3; O2 OUT1 goes to D4. Machine input HIGH produces Arduino input HIGH because the board contains two inversions. Configure these as inputs; do not enable a contradictory pull-up scheme.

The published Eagle schematic has input connector JP2: 1 unused, 2 IN1, 3 IN2, 4 GND. Output connector JP1: 1 HV-GND, 2 OUT2, 3 HV, 4 OUT1. Use the board's printed functions; this numbering is not an instruction to count left to right from an arbitrary photograph.

Including the onboard 220-ohm resistor, nominal input current is approximately 6-12 mA over 9-16 V. At 16 V, low LED forward voltage and resistor tolerances, the external resistor dissipates about 0.16 W. A 0.5 W part provides margin. Verify logic thresholds, inactive leakage and temperature on the actual machine output. These opto boards do not distinguish an open input wire from an unpressed switch.

## I2C and lamp drivers

U1 A4 = SDA and A5 = SCL. Connect these to U2 SDA/SCL and HSD1-3 D/C respectively. HSD V means logic VDD = 5 V, not load VIN. The four-pad header reads D/C/V/G. Do not plug a 3.3 V-only Qwiic peripheral into an HSD board whose VDD is 5 V: its connector power is the same VDD net.

Board | Address straps | Expected 7-bit addresses
U2 | All three address DIP switches open/OFF | 0x58
HSD1 | A1/A2/A3 open | 0x60 and 0x61
HSD2 | A1 closed to GND; A2/A3 open | 0x62 and 0x63
HSD3 | A2 closed to GND; A1/A3 open | 0x64 and 0x65

An SW8B address saved in its firmware can override straps. Scan and identify all seven addresses; a scan alone does not prove the right device or pin mode. Leave every HSD SJSDA/SJSCL jumper open, MAX AMP jumpers open, and the default VIN divider intact. Record factory jumper states before changes. The DAC's 4.7 kohm pull-ups provide approximately 1 mA sink current. At 100 kHz they support about 250 pF under the standard 1-microsecond rise-time criterion; measure the actual assembled bus if cable/layout uncertainty remains. Do not extend I2C to the cab or valve.

With the V2 board viewed component-side, output terminals at the right: top supply block is VIN then GND from left to right; bottom block is GND then VIN. Verify silkscreen and continuity before powering. Output terminals are printed 7 at the top through 0 at the bottom. The switched-positive terminal is toward the board interior; its paired G terminal is toward the outside. The schematic's OUT1 is printed channel 7, and OUT8 is printed channel 0. This reversal is intentional and agrees with the manufacturer's library; it is not a library bank-mapping defect.

Lamp | Blue positive | White positive | Common negative
1 | HSD1 ch0 | HSD1 ch1 | 0V
2 | HSD1 ch2 | HSD1 ch3 | 0V
3 | HSD1 ch4 | HSD1 ch5 | 0V
4 | HSD1 ch6 | HSD1 ch7 | 0V
5 | HSD2 ch0 | HSD2 ch1 | 0V
6 | HSD2 ch2 | HSD2 ch3 | 0V
7 | HSD2 ch4 | HSD2 ch5 | 0V
8 | HSD2 ch6 | HSD2 ch7 | 0V
9 | HSD3 ch0 | HSD3 ch1 | 0V
10 | HSD3 ch2 | HSD3 ch3 | 0V

HSD3 ch4 supplies the valve/relay branch; ch5-7 are unused and must remain OFF. A lamp effect must never iterate over all eight HSD3 outputs. Turn the old color OFF before turning the other ON. PWM is optional for lamps; the valve-power channel must remain steady DC under its watchdog state machine.

The board manufacturer reports testing to 2.4 A per four-channel bank; this is not a complete assembly qualification. The default approximately 3.9 A inrush chopping is not a branch fuse or a normal operating current. Measure each lamp color at actual charging voltage and test both worst-case blue and white patterns. Do not assume a product labeled 12 V is qualified at every voltage seen on the machine.

## Valve command, feedback and inhibit

Valve lead | Connection
Red | HSD3 printed ch4 switched-positive, VALVE_12V
Black | Main power return, 0V
Green | K1 pin 4, normally-open command contact
White | Signal return to 0V distribution; U2 OUT GND and U3 I- share this return, subject to H4
Yellow | K1 pin 7, normally-open feedback contact

U2 OUT goes to K1 pin 3, the first contact common. K1 pins 3 and 4 connect only while the coil is energized. U3 I+ goes to K1 pin 8, the second contact common; pins 8 and 7 connect while energized. K1 pins 2/9 are normally closed and are left unconnected; positions 5/6 have no function for the selected single-coil, non-latching variant and must not be wired. The manufacturer's relay terminal diagram is a bottom view. Coil positive is pin 1; negative is pin 10. Verify continuity unpowered and with a current-limited 5 V coil supply before connecting the DAC or valve. No valve-motor current passes through these signal contacts.

U2 requires initialization into 0-20 mA current mode, then a closed command of 4 mA. The GP8600 is not intrinsically a 4-20 mA-only device. Use eOutputRange20MA and checked transactions. Nominal 16-bit codes are 13,107 at closed, 39,321 at half travel, and 65,535 fully open. A zero code is 0 mA, not a valid closed command. The output stage contains a boosted supply of approximately 15 V; its OUT terminal must never connect directly to the Nano's ADC.

Bench-test U2 with a separate 250-ohm, 0.1%, 0.5 W test resistor from OUT to OUT GND: expected voltages are 1, 3 and 5 V at 4, 12 and 20 mA. This is a removable test load, not part of the final valve/SEN0262 wiring. Then test the actual valve input. Its required burden voltage is not in the available manual, so adequate current-loop compliance cannot be inferred from the words "4-20 mA" alone.

U3 I+ receives valve yellow through K1; I- receives white/common. U3 VCC = 5 V and GND = 0V. SIGNAL passes through R4 = 1 kohm to Nano A0. C1 = 100 nF connects A0 to 0V; R5 = 100 kohm also connects A0 to 0V, preventing a disconnected receiver-signal wire from floating high. These two resistors slightly attenuate the signal (100/101 nominal); calibrate the complete circuit. They are filtering/bias components, not protection against accidentally applying 12 V to A0.

The receiver's nominal conversion is 120 ohms: 4-20 mA becomes 0.48-2.40 V at its SIGNAL terminal. With the added 1k/100k network, nominal A0 is about 0.475-2.376 V, or 97-486 counts with a 5.000 V, 10-bit ADC. Use measured reference voltage and endpoint calibration, not these rounded counts as exact fault thresholds. SEN0262's differential input is not an isolated input. Do not add another shunt in parallel.

Independent timeout proposal

The even SW8B at 0x64 can run a watchdog on pin/channel 4. Proposed timeout: 500 ms, refreshed every 100 ms only after successful required acquisition and control-loop progress. Normal output HIGH supplies V1 red and U4; timeout output LOW removes actuator power and releases K1. Use no automatic return to HIGH after timeout. This protects against a stalled host only if the SW8B, HSD and relay path operate correctly; it is not a certified safety channel.

The reviewed SerialWombatWatchdog::begin() sends two packets. The first sets the default state and a temporary 10 ms return delay; the second sets the delay to 0xFFFF for a latched timeout. Both must succeed. Do not arm with an open command present. Initialize and verify a closed DAC command first, then configure the watchdog and prove the second packet's behavior. A failure between the packets is a mandatory bench test. The convenience function returns no status, so a checked protocol wrapper is required. Confirm watchdog mode is present in the actual SW8B firmware image.

The HSD convenience begin() configures all eight outputs as PWM. Reconfigure channel 4 as the watchdog afterward, and never call a whole-board initialization or lamp animation on it during operation. After a timeout, a late feed must not re-energize it; recovery requires explicit reinitialization under the closed-command sequence. Arduino reset, local SW8B reset, SDA/SCL stuck low, missing DAC, failed first/second watchdog packet and unplugged modules must all be tested.

This circuit's final timing, enable sequence and fault thresholds remain H5. In normal OFF, leave actuator power available long enough to close and verify closure. Do not remove its power immediately and call that water OFF. For an actuator overcurrent or uncertain command, inhibit drive and report that water may remain on. A frozen controller, broken wire, failed relay or shorted HSD can defeat parts of the response. A non-return ball valve can remain open without electricity. Use the upstream manual shutoff whenever flow cannot be confirmed stopped. Guaranteed power-failure closure would require a separate fail-closed valve or stored-energy actuator, outside this design.

## Flow meter

The selected four-wire UFM-02 variant uses red = regulated 5 V, black = 0V, yellow = IO0 flow pulses, and white = IO1 error pulses according to Table 7. Yellow has R6 = 4.7 kohm to 5 V and then R8 = 1 kohm in series to D8. White has R7 = 4.7 kohm to 5 V and then R9 = 1 kohm in series to D9. Place C2 = 100 nF across meter red/black near the protected meter connection. The pull-ups are on the meter side of the series resistors. No external shunt capacitor is placed on either pulse input because the minimum pulse width has not been specified.

The two 4.7 kohm resistors are pull-ups: the meter can pull a signal LOW; the resistor returns it HIGH when released. At 5 V each sinks about 1.06 mA when LOW. These are not series voltage-dropping resistors and do not connect 5 V directly to a signal without resistance. Connect no part of this meter circuit to 12 V.

The datasheet's prose swaps IO0/IO1 pin numbers relative to its pinout table. This design follows the explicit color/function table; confirm with water and an empty-tube test before accepting pulse/error interpretation. Error output toggles at the 10 Hz update rate; a static HIGH is not by itself a fault. The pulse variant cannot deliver a new reliable instantaneous flow estimate faster than the available pulses and internal update rate.

For the 3/8-inch model, 500 pulses represent one liter. Its documented pulse ceiling of about 111 Hz corresponds to 13.3 L/min (3.5 US gpm), even though the hydraulic maximum is listed as 20 L/min. Qualify pulse output over the actual operating range; do not promise accurate measurements at 20 L/min from this interface. A 1/2-inch meter has a different pulses/liter constant and cannot be substituted in software silently.

Install upstream of the control valve, with flow in the marked direction, a continuously full tube and the specified straight sections (50 mm for the 3/8-inch entry in the current installation table). Avoid an elbow/reducer immediately at the measuring section. Keep it under positive water pressure and protect it from freezing. NPS is a parallel thread, not tapered NPT; select the correct sealing adapters. Do not force a nominally matching thread.

The flow tube's pressure capability is not a weather rating for its electronics. Protect its connector/electronics from rain, condensation, sunlight and abrasion. The datasheet does not establish an IP67 outdoor assembly. The valve's IP67 rating does not transfer to the meter or controller.

## Temperature circuit and enclosure

TS1 and TS2 are normal three-wire DS18B20 sensors: pin 1 GND, pin 2 DQ, pin 3 VDD. For the selected TO-92 package, the flat marked face points toward the observer and the leads point down. Both VDD pins receive 5
V. Both DQ pins share Nano D7 and R10 = 4.7 kohm to 5 V. C3/C6 = 100 nF go across each sensor's supply locally. Do not use parasite power. Record each sensor's unique ROM ID and location; identify a replacement deliberately instead of assigning locations by discovery order.

TS1 measures representative air inside the enclosure; TS2 measures the shaded actuator region. Neither measures the motor winding directly. Protect the external sensor termination in a sealed, strain-relieved probe assembly; bare TO-92 leads are not an outdoor connector. Bound cable length and validate the 1-Wire bus in the installed arrangement. Use CRC-checked reads and nonblocking conversion; a 12-bit conversion can take 750 ms. Reject uncompleted power-on readings, including the initial 85 C value; sensor loss must not look like a safe cold temperature.

Use an opaque UV-resistant enclosure, secured board standoffs, sealed cable glands, serviceable terminals and a drip-loop arrangement. Select its dimensions after the actual modules and wire bend radii are laid out. Keep load wiring away from analog and pulse wiring. A sealed box in sunlight can exceed outside-air temperature substantially. The valve's documented ambient limit of 50 C is a system constraint, regardless of a higher Arduino or meter limit.

U4 dissipates approximately 0.3-0.5 W in the proposed 9-16 V branch with the small 5 V relay coil; confirm the measured value and enclosure temperature. The Nano regulator, DAC boost stage and HSD drivers also dissipate heat. Do not pot the entire assembly in ordinary resin. Complete electrical/thermal qualification first; prefer serviceable mounting and suitable conformal coating, keeping connectors, contacts, pressure vents and adjustment points clear. Potting chemistry, cure heat, stress and repairability would need separate qualification.

## Diagnostic coverage and firmware requirements

The circuit adds observability, not completed fault detection. HSD VIN measurement uses its default 11:1 divider. HSD3 channel-current selection measures the valve branch including U4/relay current; measure/subtract its baseline where useful. This is not isolated motor-phase current. The bank fault line also covers channels 5-7, which must be unused/OFF. Follow the manufacturer's channel selection and settling time before accepting current readings. Accuracy at very small lamp current is limited; qualify open-lamp thresholds experimentally.

The published DFRobot writeRegister() calls endTransmission() but discards its return and returns success. begin() checks an address ACK only. The production driver must propagate every transfer result, bound bus waits/retries and fail closed at the command-policy level. An ACK is not evidence of the actual output current. No checked driver has been implemented or hardware-tested here. Do not invoke the DAC's nonvolatile store() during routine operation.

Faults 1-10 retain their operator meanings in Fault Detection and Recovery. (https://github.com/aeae1/Rock-Saw-Water-Control/blob/main/docs/faults.md) The new flow meter needs detailed subcodes without inventing eleven more lamps. Use code 8 for unavailable/invalid required measurement, with position-versus-flow detail in the log; use code 5 for a characterized failure to establish or stop flow. No-flow does not identify a unique cause: supply off, air, blockage, disconnected meter and wiring failure can look alike. A disconnected open-drain output can look like a normal inactive output. Do not silently switch into unmetered operation when calibrated flow regulation requires the meter.

Power loss, watchdog reset and fault acknowledgement must never resume a previous ON/Flush command. A fault latch should survive a normal restart where storage permits; even a torn write or missing fault record must still lead to OFF, startup verification and neutral inputs. Per the 5 October control update, fault clearing requires cause removal and a fresh 3-second J hold regardless of G/H position or movement, then any unfinished closure/reference recovery and 100 ms of released J before normal commands rearm. G/H may remain held after fault acknowledgement; healthy startup still requires centered G/H. Clearing the fault must not erase the diagnostic history.

Avoid a recovery deadlock: K1 deliberately disconnects feedback when valve power is inhibited. Zero feedback during that state is expected; it is not proof of a repaired or newly broken sensor. Before a recovery attempt, verify independently observable conditions (supply, bus, temperature, valid input states and corrected wiring/obstruction). Treat actuator-dependent checks as pending requalification, not already healthy. A fresh acknowledgement may authorize one supervised closing attempt with the DAC initialized to 4 mA before enabling power. Keep the fault history/latch until powered feedback, current and closure/flow checks pass. Apply characterized startup-settle and motion deadlines; a failed attempt immediately inhibits drive again and requires a new deliberate acknowledgement after correction. Do not wait for powered feedback before supplying its power, and do not clear the fault simply because power removal made its current zero. The simulator's injected-cause controls stand in for these physical checks; this sequence still needs firmware and hardware testing.

Updated fault response policy (5 October)

The simulator and firmware contract now distinguish operator/settings faults (6, 7, 10) from movement-inhibiting faults (1–5, 8, 9). With independent actuator supervision healthy, operator faults retain valve power and issue a closed command while fault codes remain visible. A movement-inhibiting latch always wins, including after cause removal. Do not drop K1 solely because an operator code latched before the valve has closed; do drop the inhibit path on unsafe actuator conditions or watchdog expiry. Closing deadlines must survive new operator faults and acknowledgement without restarting. Reset makes no additional movement after confirmed closure, otherwise it authorizes/finishes bounded recovery and leaves water OFF. This policy changes software requirements only; the relay/sensor circuit remains unqualified and requires the bench checks described here.

Does the Arduino log faults?

Not automatically, and not yet in this project. The repository contains a simulator and firmware contract, not running Arduino firmware. USB serial output is transient unless a connected computer saves it. The Nano Every has only 256 bytes of EEPROM, so an unlimited persistent log cannot be assumed.

For the base hardware, use a bounded RAM event ring for detailed recent diagnostics, plus a small redundant EEPROM record for the most recent fault/reset summary. One possible allocation remains two 112-byte calibration/settings slots and two 16-byte diagnostic slots, totaling 256 bytes. A 16-byte diagnostic record can contain commit/schema bytes, a 16-bit sequence, 16-bit fault mask, 32-bit uptime, quantized target/position, mode/reset flags and CRC16. It cannot also hold a full curve, timestamps, voltage, current, temperature and many past events. This is a specification, not implemented storage code.

Record fault onset, added/cleared causes, acknowledgement, watchdog/brownout reset and calibration completion; coalesce repeated identical failures. Detailed RAM events should include code/subcode, uptime, raw controls, mode, requested target, measured position, supply, branch current, temperatures, flow validity and last bus error. Do not log every pulse or animation frame. Save only state changes with wear-aware transactional writes; retain the last valid record after an interrupted write. A sudden total power loss may prevent recording the final event, so report the next boot's reset cause as well.

No real-time clock is present. Records can contain uptime and sequence/boot context, but not reliable calendar dates while disconnected. A USB service command can export and inspect records later without clearing latches or moving the valve. Keep serial output nonblocking; a disconnected laptop must not stall control. For a substantial history that survives power removal, add a separately specified nonvolatile memory such as FRAM later. It is not included or wired in Revision C.

## Bench acceptance sequence

1. Unpowered inspection: match all SKUs/revisions and mark polarities. Check every scheduled wire, solder joint and net. Confirm no 12 V continuity to 5 V or signal nets; account for legitimate semiconductor paths. Check supply-to-ground resistance after capacitors settle. Verify K1 pin numbering/NO contacts and diode bands. Water and machine remain disconnected.
2. Nano only: use a current-limited nominal 12 V supply into VIN/GND; verify polarity and 5 V regulation. Check the actual board with USB absent, then service configuration separately. Set current limits for each connected stage using measured quiescent current, not a guessed final large limit.

3. Logic modules: add one module at a time. Verify 5 V load/current/temperature, seven I2C addresses, device identities, bus rise/low levels and default outputs. DFR output stays on the removable test load. All lamps and the valve remain disconnected initially.
4. Inputs: apply 0, 9, 12 and 16 V test signals separately through the completed resistor/opto circuits. Confirm D2/D3/D4 LOW/HIGH within logic limits and no channel cross-coupling. Hold every input during power-on/reset. Test G/H overlap and disconnected wires. Reverse-polarity qualification, if needed, is current-limited and separate from the Nano.
5. DAC and receiver: measure 4/12/20 mA commands with the test load. Independently test U3 with a known current source into I+/I-, verify SIGNAL and A0, then unplug SIGNAL to confirm the pull-down. Never put a multimeter in current mode directly across a voltage supply.
6. Lamp outputs: connect one lamp and identify both color leads. Test channels individually and confirm the table, including the V2 numbering reversal. Then test full patterns and thermal/current limits. Verify no pattern can energize HSD3 ch4-7. Default/reset condition must leave all lamp outputs and valve branch OFF.
7. Inhibit, no valve: use a safe dummy load on ch4. Verify U4 5 V, relay polarity/NO operation, 500 ms timeout proposal, latched timeout, no restart on a late feed, and actual power-off leakage. Test host reset, local SW8B reset, missing DAC, bus stuck-low and interruption between the two watchdog setup packets. Verify recovery can reach its powered requalification phase without requiring unavailable unpowered feedback, while never clearing a latch prematurely. Failure of any required response keeps H5 open.
8. Valve interface, no pressurized water: satisfy H4 before joining returns. Use a current-limited supply and correctly configured command source. Measure inrush, current, input burden and feedback voltage at several targets. Test close/open endpoints, signal disconnects and power loss. Determine whether feedback represents actual mechanical position during a jam; do not force or repeatedly stall the actuator.
9. Meter and temperatures: verify both sensor ROM IDs, CRC failures and unplugged-sensor behavior. Verify meter wire functions, zero/full-tube behavior, error toggling and counted volume against a measured collection. Confirm no lost pulses at the highest intended flow.
10. Water and integration: secure plumbing, provide the manual shutoff and test at low pressure first. Measure closure leak, motion time, repeatability, useful minimum opening, voltage range, full-pattern lamp current and enclosure hot soak. Inject faults by safe disconnections/test fixtures, not uncontrolled shorts. Validate power interruption during each storage phase and controls held during every reset path.
11. Machine release: resolve H1/H2, then repeat the relevant tests with the actual harness and running machine, secured attachment and safe water discharge. Record measured thresholds and acceptance evidence. Only then change the drawing status to construction/field release.

## Source register

All sources were reviewed on 4 October 2026. Manufacturer documents establish component facts; proposed combinations and calculated margins remain this project's engineering assumptions.

ID | Primary source | Used for
S1 | Nano Every datasheet, (https://docs.arduino.cc/resources/datasheets/ABX00028-datasheet.pdf) V4.0 schematic, (https://docs.arduino.cc/resources/schematics/ABX00028-schematics.pdf) pinout (https://docs.arduino.cc/resources/pinouts/ABX00028-full-pinout.pdf) | VIN, logic, pin labels, EEPROM, USB power path
S2 | PCB0046 guide, (https://www.serialwombat.com/p46) V2 schematic, (https://images.squarespace-cdn.com/content/v1/619ece9561f419760806a927/128caefe-64fd-4728-ba48-380cd703eb83/PCB_0046_V2_Schematic.png) V2 drawing (https://images.squarespace-cdn.com/content/v1/619ece9561f419760806a927/7dcc598d-3537-4cc9-8b72-35188590463b/PCB_0046_V2_Drawing.png)

Terminals, power, channel mapping, pull-ups, diagnostics

S3 | TI TPS4H160-Q1 datasheet (https://www.ti.com/lit/ds/symlink/tps4h160-q1.pdf) | Driver limits, current selection, leakage, fault behavior
S4 | Serial Wombat Arduino library, (https://github.com/BroadwellConsultingInc/SerialWombatArdLib) device firmware (https://github.com/BroadwellConsultingInc/SerialWombat) | PWM setup, watchdog packets, timeout behavior; deployed image still to verify
S5 | DFR1229 documentation, (https://wiki.dfrobot.com/dfr1229/) schematic, (https://dfimg.dfrobot.com/wiki/23289/DFR1229_gp8600-dac-module_schematics_V1.0.pdf) driver source (https://github.com/DFRobot/DFRobot_GP8XXX) | Current mode/scaling, boost stage, shared return, I2C error handling
S6 | SEN0262 documentation, (https://wiki.dfrobot.com/sen0262/) schematic (https://dfimg.dfrobot.com/wiki/17563/SEN0262_current-to-voltage_schematics_v1.pdf) | Differential shunt, analog voltage, pin functions
S7 | U.S. Solid Manual 11917 / 5003X (https://file.ussolid.com/content/JFMSV/Manual-5003X.pdf) | Valve wire colors, ratings, integrated actuator
S8 | ScioSense UFM-02 datasheet, 8 June
| 2026 (https://www.sciosense.com/wp-content/uploads/2026/06/SC-002732-DS-9-UFM-02-Datasheet.pdf) | Four-wire table, 5 V application, pull-ups, pulses, installation; pin-number prose discrepancy recorded
S9 | SparkFun BOB-09118, (https://www.sparkfun.com/sparkfun-opto-isolator-breakout.html) v1.2 schematic, (https://cdn.sparkfun.com/assets/d/e/4/5/e/Optoisolator-v12.pdf) Eagle source, (https://github.com/sparkfun/Opto_Isolator_Breakout) Vishay ILD213T family (https://www.vishay.com/docs/83647/ild205t.pdf) | Exact input circuit and pin functions
S10 | Panasonic TQ relay catalog, (https://industry.panasonic.com/ac/cdn/e/control/relay/signal/catalog/mech_eng_tq.pdf) ST L78 datasheet (https://www.st.com/resource/en/datasheet/l78.pdf)

Coil, contact numbering, regulator pins/thermal calculation

S11 | DS18B20 datasheet (https://www.analog.com/media/en/technical-documentation/data-sheets/ds18b20.pdf) | Pins, supply, conversion time, CRC
S12 | Skid Steer Genius technical reference (https://www.skidsteergenius.com/pages/technical) | Reproduced Takeuchi TL10V2/TL12V2/TL12R2 manual page 2-40; not proof of the individual harness
S13 | Nilight TL-248BW (https://www.nilight.com/products/3-4inch-dual-color-marker-light-10pcs-blue-to-white-auxiliary-side-marker-bullet-clearance-indicator-lights-3-plug-connector-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) | Common negative and separate blue/white positives; load measurements still required

## Verification performed here

This review compared manufacturer schematics, manuals, board drawings and driver source. The connection schedule is generated from an endpoint netlist; the circuit drawings were reviewed against that same specification. Automated tests check every declared pin, forbidden supply connections, unique lamp assignments, relay polarity/contact separation, address uniqueness and numeric interface margins, with deliberately damaged netlists to confirm detection. The document and diagrams were rendered for visual inspection. These checks catch documentation and design inconsistencies; they are not electrical-rule certification, hardware-in-the-loop testing, or proof of field reliability.

# Complete external connection schedule

Every row is a conductor or local soldered connection. Repeated distribution terminals denote joined bus terminals, not a bundle forced into one screw. Module-internal common connections are listed separately. Wire gauges and protection remain H2.

Wire | Net | From | To
W001 | MACHINE_12V | TB12.rail | X1.1
W002 | MACHINE_12V | TB12.rail | U1.VIN
W003 | MACHINE_12V | TB12.rail | HSD1.VIN
W004 | MACHINE_12V | TB12.rail | HSD2.VIN
W005 | MACHINE_12V | TB12.rail | HSD3.VIN
W006 | 0V | TB0.rail | X1.2
W007 | 0V | TB0.rail | U1.GND1
W008 | 0V | TB0.rail | U2.GND
W009 | 0V | TB0.rail | U3.GND
W010 | 0V | TB0.rail | HSD1.LOAD_GND
W011 | 0V | TB0.rail | HSD2.LOAD_GND
W012 | 0V | TB0.rail | HSD3.LOAD_GND
W013 | 0V | TB0.rail | O1.INPUT_GND
W014 | 0V | TB0.rail | O1.HV_GND
W015 | 0V | TB0.rail | O2.INPUT_GND
W016 | 0V | TB0.rail | O2.HV_GND
W017 | 0V | TB0.rail | V1.BLACK
W018 | 0V | TB0.rail | V1.WHITE
W019 | 0V | TB0.rail | U3.I-
W020 | 0V | TB0.rail | FM1.BLACK
W021 | 0V | TB0.rail | U4.2
W022 | 0V | TB0.rail | K1.10
W023 | 0V | TB0.rail | TS1.1
W024 | 0V | TB0.rail | TS2.1
W025 | LOGIC_5V | TB5.rail | U1.5V
W026 | LOGIC_5V | TB5.rail | U2.VCC
W027 | LOGIC_5V | TB5.rail | U3.VCC
W028 | LOGIC_5V | TB5.rail | HSD1.V

Wire | Net | From | To
W029 | LOGIC_5V | TB5.rail | HSD2.V
W030 | LOGIC_5V | TB5.rail | HSD3.V
W031 | LOGIC_5V | TB5.rail | O1.HV
W032 | LOGIC_5V | TB5.rail | O2.HV
W033 | LOGIC_5V | TB5.rail | FM1.RED
W034 | LOGIC_5V | TB5.rail | TS1.3
W035 | LOGIC_5V | TB5.rail | TS2.3
W036 | SDA | U1.A4 | U2.SDA
W037 | SDA | U1.A4 | HSD1.D
W038 | SDA | U1.A4 | HSD2.D
W039 | SDA | U1.A4 | HSD3.D
W040 | SCL | U1.A5 | U2.SCL
W041 | SCL | U1.A5 | HSD1.C
W042 | SCL | U1.A5 | HSD2.C
W043 | SCL | U1.A5 | HSD3.C
W044 | MACHINE_G | X1.3 | R1.1
W045 | OPTO_G | R1.2 | O1.IN1
W046 | OPTO_G | R1.2 | D1.K
W047 | 0V | O1.INPUT_GND | D1.A
W048 | G_LOGIC | O1.OUT1 | U1.D2
W049 | MACHINE_H | X1.4 | R2.1
W050 | OPTO_H | R2.2 | O1.IN2
W051 | OPTO_H | R2.2 | D2.K
W052 | 0V | O1.INPUT_GND | D2.A
W053 | H_LOGIC | O1.OUT2 | U1.D3
W054 | MACHINE_J | X1.5 | R3.1
W055 | OPTO_J | R3.2 | O2.IN1
W056 | OPTO_J | R3.2 | D3.K
W057 | 0V | O2.INPUT_GND | D3.A
W058 | J_LOGIC | O2.OUT1 | U1.D4
W059 | 0V | O2.INPUT_GND | O2.IN2
W060 | L1_BLUE | HSD1.CH0 | L1.BLUE

Wire | Net | From | To
W061 | L1_WHITE | HSD1.CH1 | L1.WHITE
W062 | 0V | TB0.rail | L1.BLACK
W063 | L2_BLUE | HSD1.CH2 | L2.BLUE
W064 | L2_WHITE | HSD1.CH3 | L2.WHITE
W065 | 0V | TB0.rail | L2.BLACK
W066 | L3_BLUE | HSD1.CH4 | L3.BLUE
W067 | L3_WHITE | HSD1.CH5 | L3.WHITE
W068 | 0V | TB0.rail | L3.BLACK
W069 | L4_BLUE | HSD1.CH6 | L4.BLUE
W070 | L4_WHITE | HSD1.CH7 | L4.WHITE
W071 | 0V | TB0.rail | L4.BLACK
W072 | L5_BLUE | HSD2.CH0 | L5.BLUE
W073 | L5_WHITE | HSD2.CH1 | L5.WHITE
W074 | 0V | TB0.rail | L5.BLACK
W075 | L6_BLUE | HSD2.CH2 | L6.BLUE
W076 | L6_WHITE | HSD2.CH3 | L6.WHITE
W077 | 0V | TB0.rail | L6.BLACK
W078 | L7_BLUE | HSD2.CH4 | L7.BLUE
W079 | L7_WHITE | HSD2.CH5 | L7.WHITE
W080 | 0V | TB0.rail | L7.BLACK
W081 | L8_BLUE | HSD2.CH6 | L8.BLUE
W082 | L8_WHITE | HSD2.CH7 | L8.WHITE
W083 | 0V | TB0.rail | L8.BLACK
W084 | L9_BLUE | HSD3.CH0 | L9.BLUE
W085 | L9_WHITE | HSD3.CH1 | L9.WHITE
W086 | 0V | TB0.rail | L9.BLACK
W087 | L10_BLUE | HSD3.CH2 | L10.BLUE
W088 | L10_WHITE | HSD3.CH3 | L10.WHITE
W089 | 0V | TB0.rail | L10.BLACK
W090 | VALVE_12V | HSD3.CH4 | V1.RED
W091 | VALVE_12V | HSD3.CH4 | U4.1
W092 | RELAY_5V | U4.3 | K1.1

Wire | Net | From | To
W093 | RELAY_5V | U4.3 | D4.K
W094 | RELAY_5V | U4.3 | C5.1
W095 | 0V | K1.10 | D4.A
W096 | 0V | U4.2 | C5.2
W097 | 0V | U4.2 | C4.2
W098 | VALVE_12V | U4.1 | C4.1
W099 | DAC_OUT | U2.OUT | K1.3
W100 | VALVE_COMMAND | K1.4 | V1.GREEN
W101 | VALVE_FEEDBACK | V1.YELLOW | K1.7
W102 | FEEDBACK_IN | K1.8 | U3.I+
W103 | POSITION_RAW | U3.SIGNAL | R4.1
W104 | POSITION_ADC | U1.A0 | R4.2
W105 | POSITION_ADC | U1.A0 | R5.1
W106 | POSITION_ADC | U1.A0 | C1.1
W107 | 0V | U1.GND1 | R5.2
W108 | 0V | U1.GND1 | C1.2
W109 | LOGIC_5V | FM1.RED | R6.1
W110 | FLOW_RAW | FM1.YELLOW | R6.2
W111 | FLOW_RAW | FM1.YELLOW | R8.1
W112 | FLOW_LOGIC | R8.2 | U1.D8
W113 | LOGIC_5V | FM1.RED | R7.1
W114 | FLOW_ERROR_RAW | FM1.WHITE | R7.2
W115 | FLOW_ERROR_RAW | FM1.WHITE | R9.1
W116 | FLOW_ERROR_LOGIC | R9.2 | U1.D9
W117 | LOGIC_5V | FM1.RED | C2.1
W118 | 0V | FM1.BLACK | C2.2
W119 | LOGIC_5V | TB5.rail | R10.1
W120 | ONEWIRE | U1.D7 | R10.2
W121 | ONEWIRE | U1.D7 | TS1.2
W122 | ONEWIRE | U1.D7 | TS2.2
W123 | LOGIC_5V | TS1.3 | C3.1
W124 | 0V | TS1.1 | C3.2

Wire | Net | From | To
W125 | LOGIC_5V | TS2.3 | C6.1
W126 | 0V | TS2.1 | C6.2
W127 | MACHINE_12V | HSD1.VIN | C7.+
W128 | MACHINE_12V | HSD1.VIN | C10.1
W129 | 0V | HSD1.LOAD_GND | C7.-
W130 | 0V | HSD1.LOAD_GND | C10.2
W131 | MACHINE_12V | HSD2.VIN | C8.+
W132 | MACHINE_12V | HSD2.VIN | C11.1
W133 | 0V | HSD2.LOAD_GND | C8.-
W134 | 0V | HSD2.LOAD_GND | C11.2
W135 | MACHINE_12V | HSD3.VIN | C9.+
W136 | MACHINE_12V | HSD3.VIN | C12.1
W137 | 0V | HSD3.LOAD_GND | C9.-
W138 | 0V | HSD3.LOAD_GND | C12.2

## Internal connections - no added wire

HSD1.LOAD_GND = HSD1.G; HSD1.LOAD_GND = HSD1.G0; HSD1.LOAD_GND = HSD1.G1; HSD1.LOAD_GND = HSD1.G2; HSD1.LOAD_GND = HSD1.G3; HSD1.LOAD_GND = HSD1.G4; HSD1.LOAD_GND = HSD1.G5; HSD1.LOAD_GND = HSD1.G6; HSD1.LOAD_GND = HSD1.G7; HSD2.LOAD_GND = HSD2.G; HSD2.LOAD_GND = HSD2.G0; HSD2.LOAD_GND = HSD2.G1; HSD2.LOAD_GND = HSD2.G2; HSD2.LOAD_GND = HSD2.G3; HSD2.LOAD_GND = HSD2.G4; HSD2.LOAD_GND = HSD2.G5; HSD2.LOAD_GND = HSD2.G6; HSD2.LOAD_GND = HSD2.G7; HSD3.LOAD_GND = HSD3.G; HSD3.LOAD_GND = HSD3.G0; HSD3.LOAD_GND = HSD3.G1; HSD3.LOAD_GND = HSD3.G2; HSD3.LOAD_GND = HSD3.G3; HSD3.LOAD_GND = HSD3.G4; HSD3.LOAD_GND = HSD3.G5; HSD3.LOAD_GND = HSD3.G6; HSD3.LOAD_GND = HSD3.G7; U4.2 = U4.TAB; U1.GND1 = U1.GND2; U2.GND = U2.OUT_GND

## Unused external terminals

O1.JP2_1; O2.JP2_1; O2.OUT2; K1.2; K1.9; K1.5; K1.6; HSD3.CH5; HSD3.CH6; HSD3.CH7; U1.3V3; U1.A1; U1.A2; U1.A3; U1.A6; U1.A7; U1.AREF; U1.RESET1; U1.RESET2; U1.RX; U1.TX; U1.D5; U1.D6; U1.D10; U1.D11; U1.D12; U1.D13

# Complete parts schedule

Values specify the proposed circuit. Distribution hardware, cable sizes, sealed connectors and enclosure remain subject to physical hold points. Test instruments and the removable DAC test resistor are not installed circuit components.

Ref | Specification | Note
X1 | Reused machine harness; verify actual cavities
TB12 | 12 V distribution | Joined terminals; hardware and wire rating subject to H2
TB5 | Logic 5 V distribution | Joined terminals; hardware and wire rating subject to H2
TB0 | Ground distribution | Joined terminals; hardware and wire rating subject to H2
U1 | Arduino Nano Every ABX00028
U2 | DFRobot DFR1229
U3 | DFRobot SEN0262
HSD1 | Serial Wombat PCB0046 HSD V2
HSD2 | Serial Wombat PCB0046 HSD V2
HSD3 | Serial Wombat PCB0046 HSD V2
O1 | SparkFun BOB-09118 v1.2
O2 | SparkFun BOB-09118 v1.2
V1 | U.S. Solid USS-MSV50030
FM1 | ScioSense UFM-02-03NP4
U4 | ST L7805ABV TO-220
K1 | Panasonic TQ2-5V single-side-stable
TS1 | DS18B20+ TO-92
TS2 | DS18B20+ TO-92
L1 | Nilight TL-248BW
L2 | Nilight TL-248BW
L3 | Nilight TL-248BW
L4 | Nilight TL-248BW
L5 | Nilight TL-248BW
L6 | Nilight TL-248BW
L7 | Nilight TL-248BW
L8 | Nilight TL-248BW
L9 | Nilight TL-248BW

Ref | Specification | Note
L10 | Nilight TL-248BW
R1 | 1000 ohm 1% 0.5 W
D1 | 1N4148, axial | Band = K / cathode
R2 | 1000 ohm 1% 0.5 W
D2 | 1N4148, axial | Band = K / cathode
R3 | 1000 ohm 1% 0.5 W
D3 | 1N4148, axial | Band = K / cathode
R4 | 1000 ohm 1% 0.25 W
R5 | 100000 ohm 1% 0.25 W
R6 | 4700 ohm 1% 0.25 W
R7 | 4700 ohm 1% 0.25 W
R10 | 4700 ohm 1% 0.25 W
R8 | 1000 ohm 1% 0.25 W
R9 | 1000 ohm 1% 0.25 W
D4 | 1N4148, axial | Band = K / cathode
C1 | 100 nF X7R 50 V
C2 | 100 nF X7R 50 V
C3 | 100 nF X7R 50 V
C5 | 100 nF X7R 50 V
C6 | 100 nF X7R 50 V
C10 | 100 nF X7R 50 V
C11 | 100 nF X7R 50 V
C12 | 100 nF X7R 50 V
C4 | 330 nF X7R 50 V
C7 | 47 uF 35 V 105 C electrolytic
C8 | 47 uF 35 V 105 C electrolytic
C9 | 47 uF 35 V 105 C electrolytic
