aeae1/Rock-Saw-Water-Control/docs/assets/artwork/original.jpeg

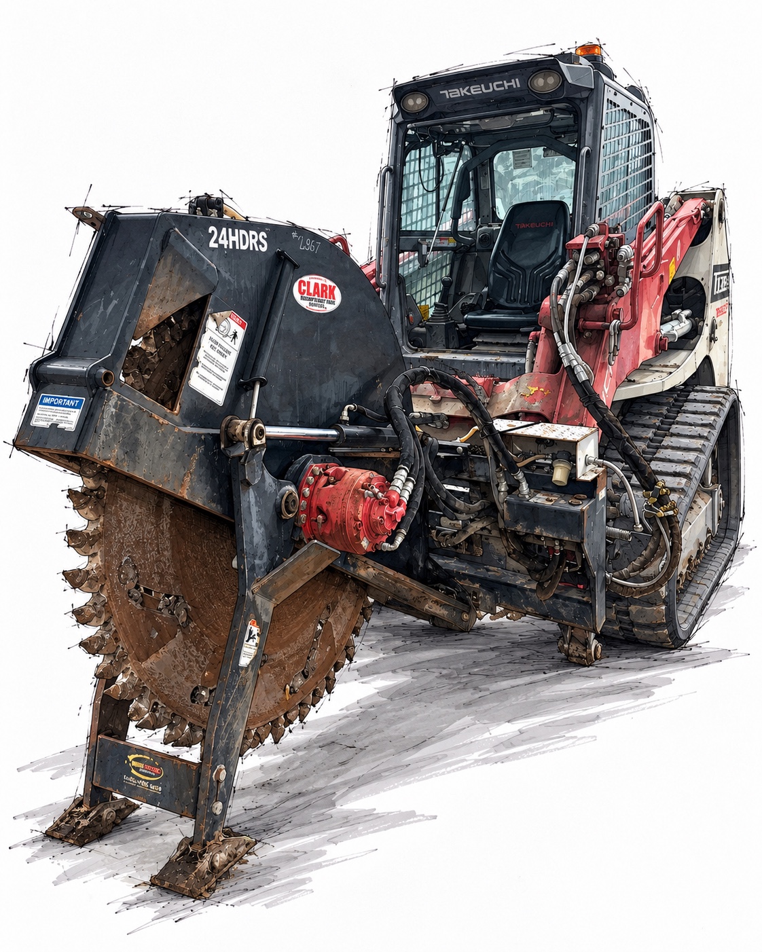
docs/assets/artwork/original.jpeg
