aeae1/Rock-Saw-Water-Control/docs/assets/hardware/water-controller-single-page-rev-d.png

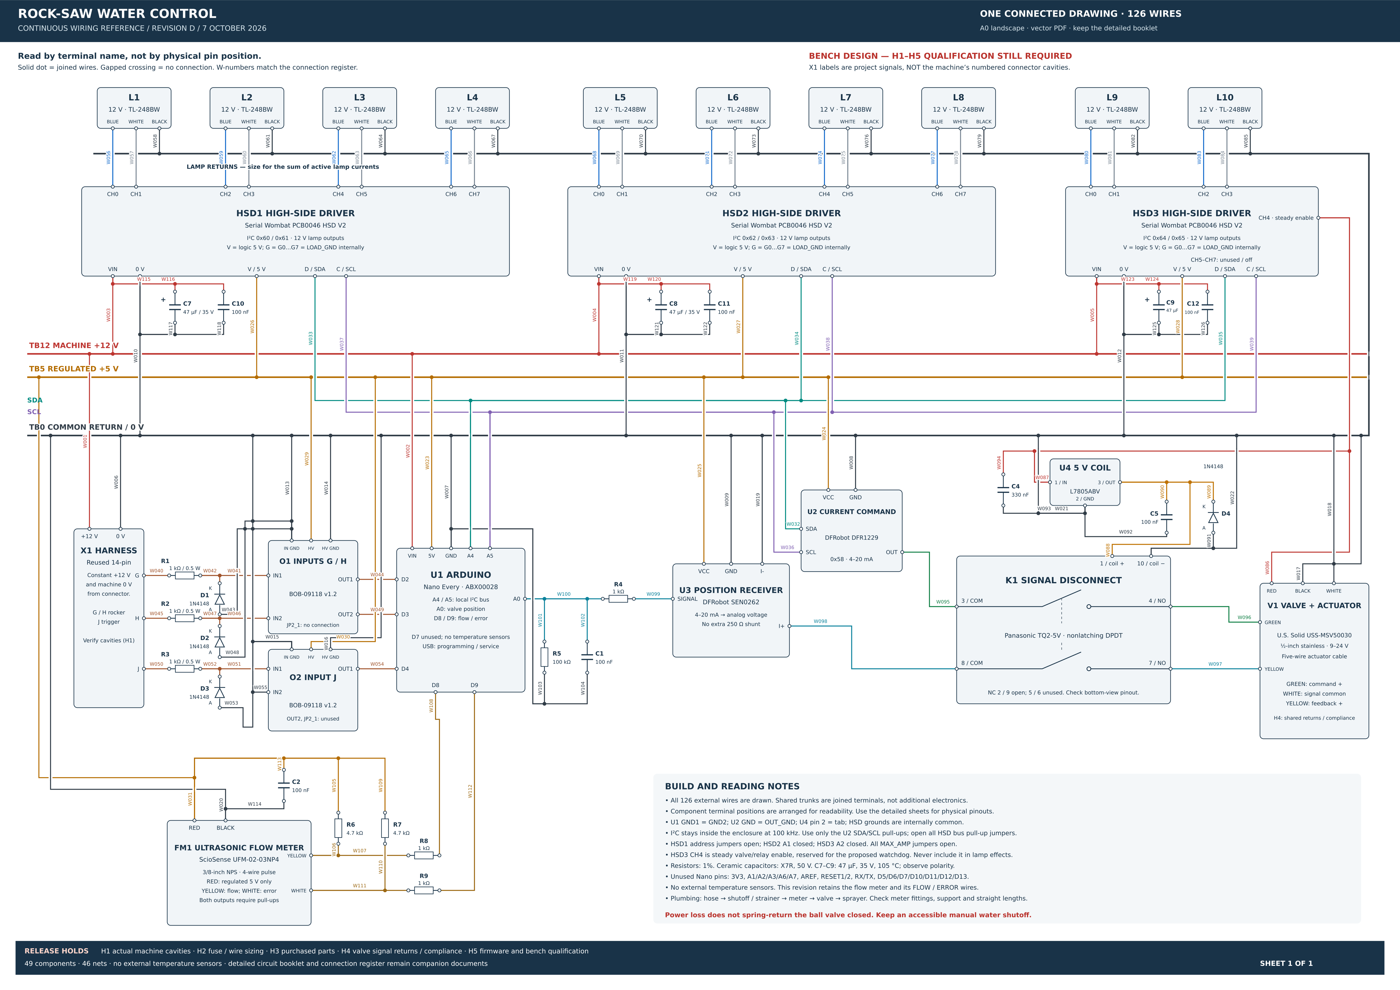
docs/assets/hardware/water-controller-single-page-rev-d.png
