aeae1/Rock-Saw-Water-Control/docs/shopping-guide.md

# Procurement and Enclosure Plan

Prices reviewed 7 October 2026 · Design updated 8 October 2026 · USD · Revision G

**[Open the shopping list (Markdown)](shopping-list.md)** · [Continuous single-page schematic](assets/hardware/water-controller-single-page-rev-g.pdf) · [Electrical audit](hardware-audit-rev-g.md) · [Exact circuit parts](../hardware/rev-g/bom.csv)

The Markdown list is the primary purchasing reference. It includes quantities, sellers, links, prices, alternatives and the complete budget without requiring a spreadsheet. This guide supplies the detailed enclosure and testing notes.

This guide includes the controller, twenty lamp channels, proportional valve, enclosure materials, assembly supplies and temporary bench accessories. It does not authorize substitutions in the Revision G schematic. Firmware v1 is supplied and compiled; software tests do not qualify assembled electronics.

## Cost and purchase status

The conservative **buy-everything planning total is approximately $626**, excluding a bench supply and tools that may already be owned. This is **not a delivered quotation**: $266 of the $512 merchandise budget consists of explicit allowances. These include $90 for the three unpriced driver boards, $75 for wiring/assembly materials, and allowances for plumbing and secondary housings. Actual purchases may be lower when suitable materials are reused, or higher when unresolved parts are quoted.

| Budget component | USD |
| :--- | ---: |
| Items with observed published prices, including small parts and spares | 246.10 |
| Merchandise allowances, including unpriced drivers and assembly supplies | 266.00 |
| Merchandise subtotal | 512.10 |
| Combined shipping allowances | 46.00 |
| Unquoted tariff/fee reserve | 20.00 |
| Estimated tax at 8.25% on the above | 47.69 |
| **Planning total; supply and additional tools excluded** | **625.79** |

Revision G removes Q1/R11/R12 and retains the internal Nano watchdog. Its planning total is $625.79, compared with $626.71 for Revision F. The earlier $200 target is still unmet. Reuse supplies and resolve unpriced drivers before purchasing; these allowances are not a delivered quote.

**Resolve these before placing the complete order:**

- **Driver procurement:** PCB0046 HSD V2 price and retail stock could not be verified. Its $30/unit allowance is invented only as an editable budget assumption, not a supplier offer. Confirm the exact V2 boards before buying the rest of the harness or cutting the enclosure.
- **Physical fit:** confirm board dimensions, mounting holes, connector heights, cable diameters and wire bends before drilling. Neither enclosure option below has a completed mechanical layout.
- The electrical audit's H1–H5 machine, protection, component, valve-interface and firmware/bench holds remain open. In particular, the five-wire valve's shared returns and loop compliance still require verification.

## Controller, valve and sensors

Prices below exclude tax and shipping unless stated. A published price does not establish in-stock availability or delivery to a particular address.

| Type / quantity | Preferred item and purchase link | Price | Alternative or selection note |
| :--- | :--- | ---: | :--- |
| Controller, 1 | [Nano Every ABX00028 at SparkFun](https://www.sparkfun.com/arduino-nano-every.html) | $13.70 | [Arduino USA](https://store-usa.arduino.cc/products/nano-every) lists $12.90. Combine SparkFun with both input boards if that avoids another shipping charge. Verify supplied headers; allow two 15-pin rows and sockets. |
| Valve, 1 | [U.S. Solid USS-MSV50030 / JFMSV50030](https://ussolid.com/products/1-2-proportional-motorized-ball-valve-stainless-steel-dc-9-24v-4-20ma-control-5-wire-ip67-full-port) | $105.29 | Selected 1/2-inch stainless, five-wire 4–20 mA model. Integrated actuator; no extra motor, H-bridge or Tuya controller. Match the exact SKU, not merely the blue housing. |
| Current command, 1 | [DFRobot DFR1229](https://www.dfrobot.com/product-3073.html) | $15.90 | Keep this low-voltage-powered model. The $9.90 DFR0972 comparison model requires 18–24 V, adding a converter for this project. |
| Feedback receiver, 1 | [DFRobot SEN0262](https://www.dfrobot.com/product-1755.html) | $4.90 | Its cost is small; retain the documented receiver and input filter rather than redesigning around a bare 250-ohm shunt. |
| Input interface, 2 | [SparkFun BOB-09118](https://www.sparkfun.com/sparkfun-opto-isolator-breakout.html) | $5.95 each | Four available opto channels; use three. External resistors/diodes remain necessary. Generic PC817 boards vary in input and output wiring and are not a qualified replacement. |
| Lamp drivers, 3 | [Serial Wombat PCB0046 HSD V2](https://www.serialwombat.com/p46) | **Unverified** | [Manufacturer's Amazon store](https://www.amazon.com/stores/SerialWombat/page/8AE4C563-9A41-45F5-B1CE-5BA3690D4918). Confirm exact model/stock. Budget contains $90 total solely as an allowance. |
| Lamps, 10 | [Nilight TL-248BW direct](https://www.nilight.com/products/3-4inch-dual-color-marker-light-10pcs-blue-to-white-auxiliary-side-marker-bullet-clearance-indicator-lights-3-plug-connector-ip68-wa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) · [Amazon alternative](https://www.amazon.com/Nilight-Clearance-Indicator-Trailer-Warranty/dp/B0F7XP3QZB) | **$25.99 / ten-pack** direct | Manufacturer lists stock and free continental-US shipping over $19.99. Separate blue/white positives and common black negative. Amazon price remains unverified; compare its exact pack/seller at checkout. Confirm current on the delivered lamps. |

The Nano Every is retained: it accepts the nominal machine supply at VIN, has 5 V logic and avoids changing every interface. Its regulated 5 V rail supplies the logic modules; **12 V never goes to a Nano I/O pin**. The valve position receiver remains installed. The lamp/valve power paths bypass the Nano's regulator. Actual peripheral current and enclosed temperature still need measurement.

The three HSD boards serve twenty lamp colors; HSD3 CH4–CH7 are unused. A PCA9685 alone is neither a 12 V power switch nor a twenty-channel replacement. Mechanical relay banks are unsuitable for the repeated animation duty. [MIKROE-6074 IPD Click](https://www.mikroe.com/ipd-click-tpd2015) was a documented eight-channel high-side alternative at $29 in the 4 October review, when the manufacturer showed it out of stock; its control interface and supervision would require a redesign. It is not included in the purchase list.

## Enclosures and weather protection

**Preferred main box: Hammond 1554VA2GY, opaque light-gray polycarbonate, nominal 240 × 160 × 90 mm (about 9.4 × 6.3 × 3.5 inches).** It offers a reasonable first-build compromise between compactness and access to terminals. Keep the valve and water fittings outside the electronics compartment.

| Option | Box price | Notes |
| :--- | ---: | :--- |
| [Hammond 1554VA2GY](https://www.automationdirect.com/adc/shopping/catalog/enclosures_-a-_racks/miniature_cases/1554va2gy), preferred | $43.50 | Add [1554VAPL plate](https://www.automationdirect.com/adc/shopping/catalog/enclosures_-a-_racks/subpanels/1554vapl), $9.25. Box + plate = $52.75, or **$57.10 with estimated 8.25% tax** if advertised free shipping applies. |
| [Hammond 1554U2GY](https://www.automationdirect.com/adc/shopping/catalog/enclosures_-a-_racks/miniature_cases/1554u2gy), compact candidate | $30.50 | Nominal 200 × 120 × 91 mm. Smaller footprint, likely needs two mounting levels and more difficult cable routing. Plate extra; do not buy until fit is demonstrated. |
| Generic Amazon gasketed box | Not quoted | Only consider a documented UV-resistant polycarbonate model with a credible ingress rating and usable internal dimensions. Many inexpensive look-alikes are ABS; no exact generic model is approved here. |

[Hammond documents UV stabilization and IP66/IP67/IP68 testing for these polycarbonate models](https://www.hammfg.com/electronics/small-case/plastic/1554). Select **1554VA2GY**, with the `A`: the similarly named 1554V2GY has different published enclosure ratings. Ratings apply to the manufactured enclosure; drilled holes, lamp penetrations and cable entries need their own appropriate seals. An IP68 marking does not mean unlimited submersion or pressure-washer resistance.

Plan a removable plate with boards on standoffs, access to USB, separate load and signal wiring, and enough clearance to tighten each terminal. Use external mounting features or sealed specified hardware rather than casually drilling mounting holes through the wet boundary. Keep the lid gasket clean and close it to the manufacturer's instructions. Shade the box where possible; the valve's 50 °C ambient limit remains a constraint even if other parts tolerate more heat.

For cable entries, [Bimed BM-ENX-2S-W](https://www.automationdirect.com/adc/shopping/catalog/wire_-a-_cable_management/cable_glands/metric_thread/bm-enx-2s-w) is a documented **$3.25 five-pack**, M12 × 1.5, for **3–6.5 mm cable outside diameter**, with mounting hardware. Other cables will need different sizes. A normal gland seals around one round cable jacket; several loose wires shoved through one hole leave leak paths. Use a matching multi-hole insert or proper jacketed cable. Put entries low or downward with drip loops and strain relief. Seal unused holes with rated plugs.

The ten lamps also need a mounting rail and protection for rear connections. Approximately 300 mm overall length is a starting layout allowance, not a drill template; measure the supplied grommets and choose readable spacing. A weather-rated lamp body does not establish a watertight cable connector or panel penetration. The Markdown budget allows $15 for this rail/cover but no finished rated assembly is selected. No separate meter housing is purchased in Revision G. Keep possible plumbing leaks away from control boards.

### Coating and potting

Use the gasketed enclosure first, followed by a thin electronics conformal coating after all soldering, cleaning and tests. [MG Chemicals 422C](https://www.mgchemicals.com/downloads/tds/tds-422c-l.pdf) is a serviceable coating option; the $20 Markdown budget entry is an allowance for a small bottle, not a verified current offer. [Amazon search](https://www.amazon.com/s?k=MG+Chemicals+422C+55ml).

Mask USB contacts, screw terminals, headers, adjustments and service test points. Follow the coating's compatibility, cure and ventilation instructions. Coating helps against moisture and contamination; it does not turn connectors or an unsealed assembly into an immersion-rated product.

Do not fill the first build with epoxy, polyester casting resin or household silicone. Suitable electronics-grade, noncorrosive silicone can later support a vulnerable joint or form a separately qualified sealed probe. Full encapsulation needs a specific compound, compatible cure process, thermal design and a repair plan. Neutral cure alone does not establish suitability for every component. The relay-coil regulator is removed. The Nano regulator, DAC and drivers still produce heat. Measure the closed-box temperature before deciding whether to encapsulate anything.

## Small parts and assembly supplies

These are required even though several are inexpensive. Prefer specified components from an authorized distributor rather than unidentified assortments where voltage rating, dielectric or tolerance cannot be verified.

The [small-parts section of the Markdown shopping list](shopping-list.md#small-electronic-parts) is the authoritative purchase table. Five exact DigiKey lots total **$9.06**, including spares. The separate removable 250-ohm bench load adds $3.36. R1–R4 share the 1 kohm, 0.5 W part. Q1/R11/R12 are omitted. Retain the three local HSD bypass capacitor pairs.

All **41 schematic references** are covered by modules, small parts, three buses, ten lamps and the reused connector. K1/U4/D4/C4/C5 are removed. All three HSD local 47 uF / 100 nF pairs remain. There are no flow or temperature sensors.

| Assembly type | Planning quantity / budget | Selection guidance and shopping link |
| :--- | :--- | :--- |
| Carrier boards and headers | 1 set / $8 | [FR4 perfboard and 2.54 mm headers](https://www.amazon.com/s?k=FR4+perfboard+2.54mm+headers+female+socket). Use secured soldered connections in the final assembly. |
| Distribution | 3 separate buses / $10 | [Covered terminals](https://www.amazon.com/s?k=covered+barrier+terminal+block+bus+bar). Label 12 V, regulated 5 V, and ground distinctly; check each terminal's wire range and rating. |
| Internal wire | Small assortment / $10 | [Stranded copper hookup wire](https://www.amazon.com/s?k=stranded+copper+hookup+wire+22+awg+kit). 22 AWG is a signal-wire planning choice, not approval for the fused supply or common lamp return. |
| Outdoor harness | Measured runs / $20 | [Jacketed multicore copper cable](https://www.amazon.com/s?k=outdoor+multiconductor+copper+control+cable). Final gauge, length and conductor count remain layout/protection decisions. Keep I2C local to the box. |
| Detachable connections | As needed / $12 | [Sealed connector examples](https://www.amazon.com/s?k=Deutsch+DT+sealed+connector+kit). Verify authentic contacts, current limits, wire seals and crimp tool. Permanent gland entry can avoid some connector expense. |
| Finishing | Small lot / $8 | [Adhesive-lined shrink, ferrules, labels](https://www.amazon.com/s?k=adhesive+lined+heat+shrink+ferrules+wire+labels), abrasion sleeve and cable ties. Do not put solder-tinned stranded ends under terminals that prohibit them. |
| Mounting | Small lot / $7 | [PCB standoffs](https://www.amazon.com/s?k=nylon+pcb+standoff+M3+kit), screws and brackets. Keep solder points clear of the steel plate. |

Amazon links described as **searches** are comparison starting points, not approved exact products or verified checkout prices. The existing machine connector, machine supply/ground, hose, battery and multimeter are reused and are not charged again. No separate machine battery cable or additional machine fuse block is included. The existing fuse still has to protect the actual added conductors.

## Plumbing

Allow $20 for a [manual shutoff and cleanable strainer](https://www.amazon.com/s?k=garden+hose+shut+off+valve+inline+filter+brass), $15 for [garden-hose/NPT adapters](https://www.amazon.com/s?k=3%2F4+GHT+to+1%2F2+NPT+brass+adapter), and $8 for short pipe, washers, supports and sealant as needed. These are estimates; reuse suitable existing parts. The meter's separate $20 adapter allowance is removed.

Water path: **garden hose → manual shutoff / strainer → proportional valve → sprayer**. US garden hose thread is 3/4-inch GHT; the valve has 1/2-inch NPT ports. Match gender and sealing method on both adapter ends. Support the valve and hose so hose pulls do not load the fittings. There is no NPS meter interface or meter-specific straight-run requirement in this build. Electrical power removal does not mechanically return the valve closed, so retain the manual shutoff.

An optional bucket-and-stopwatch calibration can be done with existing tools and a known-volume container; no permanent meter is required. Capture all spray outlets through the real nozzle arrangement. A saved curve estimates flow at similar supply conditions; it cannot detect an empty supply, blockage or leaking closed valve. See [Flow calibration](flow-calibration.md).

## Optional bench supply and battery-first work

**A multimeter and a 12 V battery are enough for continuity checks and cautious, staged nominal-voltage testing. They do not provide adjustable current limiting or establish all acceptance criteria.** The work can start without purchasing a bench supply; the valve should be connected only after the relevant inexpensive interfaces have passed their checks.

| Option | Cost basis | Assessment |
| :--- | :--- | :--- |
| Existing battery + temporary fused test lead | $10 allowance for lead/small fuses | Budget route. A fuse addresses a shorted wire; it may not save a semiconductor from a wrong connection. No refund or cheap-failure outcome is guaranteed. |
| [FNIRSI DPS-150](https://www.fnirsi.com/products/dps-150) | $57.99 without input adapter; advertised code **DPS154** deducts $4 if accepted | Approx. **$58.44 including estimated tax** after the code if advertised free shipping applies. This excludes its input adapter. It is a **step-down** instrument: for a regulated 12 V output use a suitable higher-voltage supply, such as a compatible 20 V USB-C PD source with adequate power. A phone charger or nominal 12 V battery is not automatically sufficient. |
| [Jesverty SPS-3010](https://www.amazon.com/dp/B09YSJQWRG) | $60 planning allowance, **Amazon price unverified** | Conventional AC-powered adjustable CC/CV unit; simpler if buying everything together. Select a US 110/120 V input version. A 10 A capability does not mean the first test should use a 10 A limit. [Manufacturer product/manual page](https://www.jesverty.com/products/view?id=10448&lang=en). |

The bench supply is not part of the installed machine. Start it at 12.0 V with a low stage-appropriate current limit, output off while wiring, and verify voltage with the multimeter before attaching electronics. A current-limited supply still cannot guarantee survival of a reversed connection or 12 V applied to a logic pin.

For the battery route:

1. **Prepare a removable test harness.** Put the inline fuse close to battery positive and use insulated, polarity-labeled connections on a nonconductive surface. Keep the machine harness, valve and water disconnected. Select the fuse from the expected test-stage load and the weakest conductor, not from the battery's capacity. Do not increase it to cure an unexplained blown fuse. This bench lead is separate from the final existing-fuse machine installation.
2. **Check unpowered work.** Confirm every connection, diode band, capacitor polarity and module orientation against Revision G. Use continuity/resistance only with power removed. A capacitor can briefly affect readings; investigate a persistent short rather than treating every initial beep as one.
3. **Test the Nano alone.** Disconnect USB and all external modules. Measure battery polarity/voltage first, then connect positive to **VIN**, negative to **GND**. Measure the 5 V header relative to ground before attaching anything to it. Expect approximately 5 V; stop for an unexpected reading or rapid heating. Recheck after each added load.
4. **Add one inexpensive interface at a time, power removed between changes.** Test the input boards and their completed resistor/diode circuits before connecting Nano input pins. Never apply battery voltage directly to a logic terminal. Use the [firmware v1 upload guide](../firmware/README.md) for the supplied Nano Every application; physical functional tests remain necessary.
5. **Test the command module on its resistor, not the valve.** Across the removable 250-ohm resistor, 4, 12 and 20 mA should produce approximately 1, 3 and 5 V. This lets the meter stay in DC-voltage mode. Test the feedback receiver separately with a known current source before exposing the Arduino ADC.
6. **Test one lamp and one output before the full bar.** Confirm color leads and current, then add channels. Test the internal Nano watchdog with the valve disconnected. HSD3 CH4–CH7 must remain off. Check bounded communication recovery after a peripheral reset.
7. **Connect the valve last.** First resolve signal-return and loop-compliance questions. Dry motion and feedback tests precede water tests. Keep the manual shutoff accessible, start at low pressure and support the plumbing.

Keep the multimeter black lead in COM and the red lead in V/Ω for these voltage checks. **Do not place a meter set to amps across the battery.** Current measurement requires a different, series connection and the correct fused meter input; it is not necessary for the first voltage checks above.

A fixed battery cannot test the full 9–16 V input range, and a basic multimeter cannot establish short pulse integrity, I2C rise time or brief brownout behavior. Those audit items remain unverified until suitable borrowed equipment or another qualified test method is available. A successful battery test is progress toward qualification, not proof that every hardware fault detector works.

If not already owned, separately allow roughly $35 for a temperature-controlled soldering tool, $30 for appropriate stripping/crimping/drilling tools, and $15 for electronics solder/flux/cleaning materials. Connector choice may require a more expensive matched crimper. These estimates are excluded from the $626 build budget. A computer and data-capable Micro-USB cable are needed for programming; the Markdown budget includes a $5 cable allowance that can be set to zero if owned.

## Shipping, tax and coupons

The Markdown budget uses **8.25% as a Helotes-area planning rate**, based on the [Texas Comptroller city-rate table](https://comptroller.texas.gov/taxes/sales/docs/city-rates.pdf). ZIP 78023 alone does not identify every delivery address's tax jurisdiction. Confirm the actual rate at checkout. Texas generally includes delivery charges associated with taxable goods in the taxable amount; see [Comptroller guidance](https://comptroller.texas.gov/taxes/sales/faq/collection.php). The Markdown budget conservatively taxes its entire shipping/fee reserve as well; this is a budgeting assumption, not a final tax determination.

| Basket | Shipping budget | What was established |
| :--- | ---: | :--- |
| U.S. Solid | $10 allowance | [Weight-based rates at checkout](https://ussolid.com/policies/shipping-policy); no destination quote obtained. |
| SparkFun | $8 allowance | Combine Nano and two opto boards. |
| DFRobot | $8 allowance | Combine DAC and receiver. Manufacturer notice says direct shipping resumes October 8 after its holiday closure. |
| DigiKey | $10 allowance | One small-component basket; no destination checkout quote obtained. Possible tariff charges remain unquoted. |
| AutomationDirect | $0 assumed | Advertises free eligible shipping over $49; the box and plate total $52.75. Confirm split/drop-ship conditions at checkout. |
| Amazon / local / other | $10 allowance | Prime eligibility, seller terms and final item choices are unknown. The Nilight ten-pack separately qualifies for its advertised free continental-US shipping; no extra lamp shipping is budgeted. |

The separate **$20 tariff/fee reserve is not a calculated tariff or an upper limit**. Replace it with the actual charges when known. The model uses one shipping allowance per basket, not one per component.

The only directly observed product-specific coupon in this pass was **FNIRSI DPS154 ($4)**. It is advertised on the product page but was not redeemed in checkout. It is optional and is not deducted from the installed-system budget. No verified U.S. Solid or Amazon coupon is included. Third-party “up to” coupon listings and account-specific offers were not counted as savings. No mailing-list registration, account creation or order was performed.

ZIP-specific Amazon checkout shipping, tax, coupons and exact seller prices could not be verified. Manufacturer/distributor prices above were checked on their public product pages; no destination checkout was completed. The links, dated published prices and explicit allowances remain useful for comparison; they should not be relabeled as checkout totals.

## Optional spreadsheet

The [Revision E spreadsheet](assets/procurement/shopping-list-rev-e.xlsx) is archived for historical reference. Its relay-based parts and totals are superseded; use the current [Markdown list](shopping-list.md).

The **Shopping** tab contains editable quantities/prices, formula line totals, category totals, tax, one set of shipping allowances, a fee reserve and a discount input. Set an item's quantity to zero only when it is already owned or deliberately removed from the scope. Prices marked “Allowance” are assumptions. A detailed small-parts table below the shipping section supplies the installed quantity, purchase quantity, part number and source for each of the six lots; its sum feeds the main basket without double-counting. The **Options** tab is separate and is not included in the main total, avoiding double-counting alternative controllers, enclosures and power supplies. Links and source/basis notes accompany each entry. The source data is also available in [JSON](shopping-data.json).

Purchase the small, independently testable electronics first if beginning immediately. Delay nonreturnable or layout-dependent purchases until the driver source, valve interfaces and enclosure layout are established. No potting is included in the initial assembly plan.
