aeae1/Rock-Saw-Water-Control/docs/bom.csv

Category | Item | Quantity | Unit USD | Extended USD | Seller | Basis | URL | Notes
Control | Arduino Nano Every ABX00028 | 1 | 13.70 | 13.70 | SparkFun | Published | https://www.sparkfun.com/arduino-nano-every.html | Combine with opto boards; Arduino direct is $12.90 before separate shipping. Headers required.
Water | U.S. Solid USS-MSV50030 / JFMSV50030 | 1 | 105.29 | 105.29 | U.S. Solid | Published | https://ussolid.com/products/1-2-proportional-motorized-ball-valve-stainless-steel-dc-9-24v-4-20ma-control-5-wire-ip67-full-port | 1/2-inch stainless; 9–24 V; five-wire 4–20 mA command and feedback. H4 qualification pending.
Control | DFRobot DFR1229 current command | 1 | 15.90 | 15.90 | DFRobot | Published | https://www.dfrobot.com/product-3073.html | 3.3–5 V supply; keep exact SKU. Direct shipping resumes Oct 8.
Control | DFRobot SEN0262 feedback receiver | 1 | 4.90 | 4.90 | DFRobot | Published | https://www.dfrobot.com/product-1755.html | 120-ohm receiver; analog output. Do not add a 250-ohm shunt in parallel.
Control | SparkFun BOB-09118 v1.2 input boards | 2 | 5.95 | 11.90 | SparkFun | Published | https://www.sparkfun.com/sparkfun-opto-isolator-breakout.html | Three channels used; external input resistors/diodes still required.
Display | Serial Wombat PCB0046 HSD V2 | 3 | 30.00 | 90.00 | Serial Wombat | Allowance | https://www.serialwombat.com/p46 | PRICE/STOCK UNVERIFIED. $30 each is a budgeting placeholder, not a quotation. Procurement hold.
Display | Nilight TL-248BW blue/white lamps | 1 | 25.99 | 25.99 | Nilight direct | Published | https://www.nilight.com/products/3-4inch-dual-color-marker-light-10pcs-blue-to-white-auxiliary-side-marker-bullet-clearance-indicator-lights-3-plug-connector-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 | Exact TL-248BW ten-pack: $25.99 observed; advertised free continental-US shipping over $19.99. Amazon price unverified. Common negative, separate blue/white positives; measure current.
Assembly | Small electronic parts | 1 | 9.06 | 9.06 | DigiKey | Published | https://www.digikey.com/en/products/detail/yageo/MFR-50FTE52-1K/9147015 | Five exact resistor/diode/capacitor lots with spares. No Q1/R11/R12; retain three HSD bypass pairs.
Assembly | FR4 perfboard, Nano headers and sockets | 1 | 8.00 | 8.00 | Amazon | Allowance | https://www.amazon.com/s?k=FR4+perfboard+2.54mm+headers+female+socket | Soldered carrier with secure mounting; ordinary loose Dupont jumpers are for bench use only.
Assembly | 12 V, 5 V and ground distribution terminals | 1 | 10.00 | 10.00 | Amazon | Allowance | https://www.amazon.com/s?k=covered+barrier+terminal+block+bus+bar | Three separate labeled buses. Quantity depends on harness layout; size to verified fuse and loads.
Assembly | Stranded copper internal hookup wire | 1 | 10.00 | 10.00 | Amazon | Allowance | https://www.amazon.com/s?k=stranded+copper+hookup+wire+22+awg+kit | 22 AWG signal wire planning only; load/feed gauges subject to H2. Avoid copper-clad aluminum.
Assembly | Jacketed outdoor harness cable | 1 | 20.00 | 20.00 | Amazon / local | Allowance | https://www.amazon.com/s?k=outdoor+multiconductor+copper+control+cable | Measure runs first. Lamp loom needs twenty color conductors plus suitably sized common return(s).
Assembly | Locking sealed cable connectors | 1 | 12.00 | 12.00 | Amazon / distributor | Allowance | https://www.amazon.com/s?k=Deutsch+DT+sealed+connector+kit | Use genuine rated parts with matching wire seals. Reused 14-pin machine connector excluded.
Assembly | Heat shrink, ferrules, loom and labels | 1 | 8.00 | 8.00 | Amazon | Allowance | https://www.amazon.com/s?k=adhesive+lined+heat+shrink+ferrules+wire+labels | Adhesive-lined shrink at splices; secure cable strain relief. Reduce if already owned.
Assembly | Standoffs, fasteners and mounting brackets | 1 | 7.00 | 7.00 | Amazon / local | Allowance | https://www.amazon.com/s?k=nylon+pcb+standoff+M3+kit | Insulated board clearance above steel plate; mounting should not puncture the sealing cavity.
Enclosure | Hammond 1554VA2GY opaque polycarbonate | 1 | 43.50 | 43.50 | AutomationDirect | Published | https://www.automationdirect.com/adc/shopping/catalog/enclosures_-a-_racks/miniature_cases/1554va2gy | Nominal 240 x 160 x 90 mm. Preferred planning size; confirm physical layout before drilling.
Enclosure | Hammond 1554VAPL mounting plate | 1 | 9.25 | 9.25 | AutomationDirect | Published | https://www.automationdirect.com/adc/shopping/catalog/enclosures_-a-_racks/subpanels/1554vapl | Box plus plate clears advertised $49 free-shipping threshold; checkout confirmation still required.
Enclosure | Bimed BM-ENX-2S-W cable glands | 1 | 3.25 | 3.25 | AutomationDirect | Published | https://www.automationdirect.com/adc/shopping/catalog/wire_-a-_cable_management/cable_glands/metric_thread/bm-enx-2s-w | M12 x 1.5; jacket OD 3–6.5 mm. Use only where cable diameter fits; mounting hardware included.
Enclosure | Larger glands, sealing plugs and seals | 1 | 8.00 | 8.00 | AutomationDirect | Allowance | https://www.automationdirect.com/adc/overview/catalog/wire_-a-_cable_management/cable_glands | Machine/display cable may need larger glands or matched multi-hole inserts; measure first.
Enclosure | Ten-lamp rail / rear wiring cover | 1 | 15.00 | 15.00 | Local / Amazon | Allowance | https://www.amazon.com/s?k=aluminum+u+channel+12+inch | Plan approximately 300 mm long; verify actual grommet diameter/pitch. No rated finished housing selected.
Water | Manual shutoff and cleanable inlet strainer | 1 | 20.00 | 20.00 | Amazon / local | Allowance | https://www.amazon.com/s?k=garden+hose+shut+off+valve+inline+filter+brass | Reuse existing suitable items; select pressure rating and mesh for nozzle requirements.
Water | Garden-hose to valve NPT fittings | 1 | 15.00 | 15.00 | Amazon / local | Allowance | https://www.amazon.com/s?k=3%2F4+GHT+to+1%2F2+NPT+brass+adapter | US garden hose thread is 3/4 GHT, distinct from 1/2 NPT valve threads. Include removable unions as required.
Water | Straight pipe, washers, supports and sealant | 1 | 8.00 | 8.00 | Local | Allowance | https://www.amazon.com/s?k=brass+1%2F2+NPT+pipe+nipple+plumbing | Choose supports and short pipe as the valve/hose layout requires; no meter-specific straight sections or NPS fittings.
Enclosure | MG Chemicals 422C coating, small bottle | 1 | 20.00 | 20.00 | Amazon / distributor | Allowance | https://www.amazon.com/s?k=MG+Chemicals+422C+55ml | Later, after testing; mask contacts, connectors and vents. Not a substitute for the gasketed box.
Bench | Temporary fused battery lead and small fuses | 1 | 10.00 | 10.00 | Amazon / local | Allowance | https://www.amazon.com/s?k=inline+ATO+fuse+holder+1A+2A+fuse | Bench only, close to battery; size fuse to test stage and weakest wire. Not a new machine fuse block.
Bench | 250-ohm 0.1% 0.5 W removable test resistor | 1 | 3.36 | 3.36 | DigiKey | Published | https://www.digikey.com/en/products/detail/vishay-dale/RN65E2500BB14/3193953 | Vishay RN65E2500BB14: 250 ohm, 0.1%, 0.5 W. Removable DAC bench load only; never add as a permanent valve/feedback shunt.
Bench | Micro-USB data cable | 1 | 5.00 | 5.00 | Amazon / existing | Allowance | https://www.amazon.com/s?k=micro+usb+data+cable | Set quantity to zero if owned. Must carry data, not charging-only.
