aeae1/Rock-Saw-Water-Control/docs/assets/procurement/shopping-list-rev-e.xlsx

Sheet: Shopping
Rock Saw Water Control · Shopping
Revision E · no flow / temperature sensors · retained prices reviewed 7 October 2026.
Merchandise | $517.90 |  | Category | Amount |  |  |  | Main total includes estimates; optional power supplies and tools are on Options and are excluded.
Shipping | $56.00 |  | Control | $49.24
Fee reserve | $20.00 |  | Water | $148.29 |  |  |  | $20 fee reserve is not a tariff quote or a maximum. Replace with actual charges.
Discount | $0.00 |  | Display | $115.99 |  |  |  | Discount is zero: no verified coupon for the selected installed-system basket.
Tax rate | 8.25% |  | Assembly | $87.02 |  |  |  | 8.25% Helotes-area planning rate; ZIP alone does not determine the exact delivery tax jurisdiction. | https://comptroller.texas.gov/taxes/sales/docs/city-rates.pdf
Tax estimate | $49.00 |  | Enclosure | $99.00 |  |  |  | Budget assumes shipping and fees taxable. Final checkout may differ. | https://comptroller.texas.gov/taxes/sales/faq/collection.php
Planning total | $642.90 |  | Bench | $18.36 |  |  |  | Driver availability, valve interface qualification, physical fit and hardware testing remain unresolved. No meter adapters are required.
List prices | $251.90 |  |  |  |  |  |  | Published prices are observed list prices, not stock guarantees or destination checkout totals.
Allowances | $266.00 |  |  |  |  |  |  | Allowance means an editable estimate; $30 per driver is not a verified offer.
Amber cells are editable. Set quantity to 0 for suitable parts already owned. Searches are not approved exact products.
Type | Item | Qty | Buy unit | Unit USD | Price basis | Line USD | Vendor | Selection / availability notes | Source
Control | Arduino Nano Every ABX00028 | 1 | board | $13.70 | Published | $13.70 | SparkFun | Refs: U1. Combine with opto boards; Arduino direct is $12.90 before separate shipping. Headers required. | https://www.sparkfun.com/arduino-nano-every.html
Water | U.S. Solid USS-MSV50030 / JFMSV50030 | 1 | valve | $105.29 | Published | $105.29 | U.S. Solid | Refs: V1. 1/2-inch stainless; 9–24 V; five-wire 4–20 mA command and feedback. H4 qualification pending. | https://ussolid.com/products/1-2-proportional-motorized-ball-valve-stainless-steel-dc-9-24v-4-20ma-control-5-wire-ip67-full-port
Control | DFRobot DFR1229 current command | 1 | board | $15.90 | Published | $15.90 | DFRobot | Refs: U2. 3.3–5 V supply; keep exact SKU. Direct shipping resumes Oct 8. | https://www.dfrobot.com/product-3073.html
Control | DFRobot SEN0262 feedback receiver | 1 | board | $4.90 | Published | $4.90 | DFRobot | Refs: U3. 120-ohm receiver; analog output. Do not add a 250-ohm shunt in parallel. | https://www.dfrobot.com/product-1755.html
Control | SparkFun BOB-09118 v1.2 input boards | 2 | board | $5.95 | Published | $11.90 | SparkFun | Refs: O1, O2. Three channels used; external input resistors/diodes still required. | https://www.sparkfun.com/sparkfun-opto-isolator-breakout.html
Display | Serial Wombat PCB0046 HSD V2 | 3 | board | $30.00 | Allowance | $90.00 | Serial Wombat | Refs: HSD1, HSD2, HSD3. PRICE/STOCK UNVERIFIED. $30 each is a budgeting placeholder, not a quotation. Procurement hold. | https://www.serialwombat.com/p46
Display | Nilight TL-248BW blue/white lamps | 1 | 10-pack | $25.99 | Published | $25.99 | Nilight direct | Refs: L1, L2, L3, L4, L5, L6, L7, L8, L9, L10. Exact TL-248BW ten-pack: $25.99 observed; advertised free continental-US shipping over $19.99. Amazon price unverified. Common negative, separate blue/white positives; measure current. | https://www.nilight.com/products/3-4inch-dual-color-marker-light-10pcs-blue-to-white-auxiliary-side-marker-bullet-clearance-indicator-lights-3-plug-connector-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
Control | Panasonic TQ2-5V nonlatching DPDT | 1 | relay | $1.94 | Published | $1.94 | Mouser | Refs: K1. Mouser showed stock at $1.94 on 7 Oct. DigiKey $2.36 backorder is an alternate. Exact nonlatching TQ2-5V only; verify physical pin orientation. | https://www.mouser.com/en/ProductDetail/Panasonic-Industry/TQ2-5V?qs=HLLy2pIPwutHaTSpVfb1kw%3D%3D
Control | ST L7805ABV TO-220 | 1 | regulator | $0.90 | Published | $0.90 | DigiKey | Refs: U4. Dedicated relay-coil supply only; retain specified capacitors. | https://www.digikey.com/en/products/detail/stmicroelectronics/L7805ABV/634711
Assembly | Exact resistors, diodes and capacitors | 1 | small lot | $12.02 | Published | $12.02 | DigiKey | Linked from the detailed lots below; edit C68:C73 or E68:E73 to change spare quantities/prices. Six exact part numbers. | https://www.digikey.com/en/products/detail/yageo/MFR-50FTE52-1K/9147015
Assembly | FR4 perfboard, Nano headers and sockets | 1 | set | $8.00 | Allowance | $8.00 | Amazon | Soldered carrier with secure mounting; ordinary loose Dupont jumpers are for bench use only. | https://www.amazon.com/s?k=FR4+perfboard+2.54mm+headers+female+socket
Assembly | 12 V, 5 V and ground distribution terminals | 1 | set | $10.00 | Allowance | $10.00 | Amazon | Refs: TB12, TB5, TB0. Three separate labeled buses. Quantity depends on harness layout; size to verified fuse and loads. | https://www.amazon.com/s?k=covered+barrier+terminal+block+bus+bar
Assembly | Stranded copper internal hookup wire | 1 | assortment | $10.00 | Allowance | $10.00 | Amazon | 22 AWG signal wire planning only; load/feed gauges subject to H2. Avoid copper-clad aluminum. | https://www.amazon.com/s?k=stranded+copper+hookup+wire+22+awg+kit
Assembly | Jacketed outdoor harness cable | 1 | length allowance | $20.00 | Allowance | $20.00 | Amazon / local | Measure runs first. Lamp loom needs twenty color conductors plus suitably sized common return(s). | https://www.amazon.com/s?k=outdoor+multiconductor+copper+control+cable
Assembly | Locking sealed cable connectors | 1 | set | $12.00 | Allowance | $12.00 | Amazon / distributor | Use genuine rated parts with matching wire seals. Reused 14-pin machine connector excluded. | https://www.amazon.com/s?k=Deutsch+DT+sealed+connector+kit
Assembly | Heat shrink, ferrules, loom and labels | 1 | small lot | $8.00 | Allowance | $8.00 | Amazon | Adhesive-lined shrink at splices; secure cable strain relief. Reduce if already owned. | https://www.amazon.com/s?k=adhesive+lined+heat+shrink+ferrules+wire+labels
Assembly | Standoffs, fasteners and mounting brackets | 1 | small lot | $7.00 | Allowance | $7.00 | Amazon / local | Insulated board clearance above steel plate; mounting should not puncture the sealing cavity. | https://www.amazon.com/s?k=nylon+pcb+standoff+M3+kit
Enclosure | Hammond 1554VA2GY opaque polycarbonate | 1 | box | $43.50 | Published | $43.50 | AutomationDirect | Nominal 240 x 160 x 90 mm. Preferred planning size; confirm physical layout before drilling. | https://www.automationdirect.com/adc/shopping/catalog/enclosures_-a-_racks/miniature_cases/1554va2gy
Enclosure | Hammond 1554VAPL mounting plate | 1 | plate | $9.25 | Published | $9.25 | AutomationDirect | Box plus plate clears advertised $49 free-shipping threshold; checkout confirmation still required. | https://www.automationdirect.com/adc/shopping/catalog/enclosures_-a-_racks/subpanels/1554vapl
Enclosure | Bimed BM-ENX-2S-W cable glands | 1 | 5-pack | $3.25 | Published | $3.25 | AutomationDirect | M12 x 1.5; jacket OD 3–6.5 mm. Use only where cable diameter fits; mounting hardware included. | https://www.automationdirect.com/adc/shopping/catalog/wire_-a-_cable_management/cable_glands/metric_thread/bm-enx-2s-w
Enclosure | Larger glands, sealing plugs and seals | 1 | allowance | $8.00 | Allowance | $8.00 | AutomationDirect | Machine/display cable may need larger glands or matched multi-hole inserts; measure first. | https://www.automationdirect.com/adc/overview/catalog/wire_-a-_cable_management/cable_glands
Enclosure | Ten-lamp rail / rear wiring cover | 1 | assembly allowance | $15.00 | Allowance | $15.00 | Local / Amazon | Plan approximately 300 mm long; verify actual grommet diameter/pitch. No rated finished housing selected. | https://www.amazon.com/s?k=aluminum+u+channel+12+inch
Water | Manual shutoff and cleanable inlet strainer | 1 | set allowance | $20.00 | Allowance | $20.00 | Amazon / local | Reuse existing suitable items; select pressure rating and mesh for nozzle requirements. | https://www.amazon.com/s?k=garden+hose+shut+off+valve+inline+filter+brass
Water | Garden-hose to valve NPT fittings | 1 | set allowance | $15.00 | Allowance | $15.00 | Amazon / local | US garden hose thread is 3/4 GHT, distinct from 1/2 NPT valve threads. Include removable unions as required. | https://www.amazon.com/s?k=3%2F4+GHT+to+1%2F2+NPT+brass+adapter
Water | Straight pipe, washers, supports and sealant | 1 | small lot | $8.00 | Allowance | $8.00 | Local | Choose supports and short pipe as the valve/hose layout requires; no meter-specific straight sections or NPS fittings. | https://www.amazon.com/s?k=brass+1%2F2+NPT+pipe+nipple+plumbing
Enclosure | MG Chemicals 422C coating, small bottle | 1 | bottle allowance | $20.00 | Allowance | $20.00 | Amazon / distributor | Later, after testing; mask contacts, connectors and vents. Not a substitute for the gasketed box. | https://www.amazon.com/s?k=MG+Chemicals+422C+55ml
Bench | Temporary fused battery lead and small fuses | 1 | set allowance | $10.00 | Allowance | $10.00 | Amazon / local | Bench only, close to battery; size fuse to test stage and weakest wire. Not a new machine fuse block. | https://www.amazon.com/s?k=inline+ATO+fuse+holder+1A+2A+fuse
Bench | 250-ohm 0.1% 0.5 W removable test resistor | 1 | resistor allowance | $3.36 | Published | $3.36 | DigiKey | Vishay RN65E2500BB14: 250 ohm, 0.1%, 0.5 W. Removable DAC bench load only; never add as a permanent valve/feedback shunt. | https://www.digikey.com/en/products/detail/vishay-dale/RN65E2500BB14/3193953
Bench | Micro-USB data cable | 1 | cable allowance | $5.00 | Allowance | $5.00 | Amazon / existing | Set quantity to zero if owned. Must carry data, not charging-only. | https://www.amazon.com/s?k=micro+usb+data+cable
 |  |  |  |  |  | $0.00
 |  |  |  |  |  | $0.00
 |  |  |  |  |  | $0.00
Shipping is budgeted once per supplier basket. AutomationDirect and Nilight have conditional free-shipping offers.
 | Supplier basket |  |  | Budget USD
 | U.S. Solid |  |  | $10.00 |  |  |  | Allowance; weight-based checkout quote unavailable | https://ussolid.com/policies/shipping-policy
 | SparkFun |  |  | $8.00 |  |  |  | Allowance; combine Nano and both opto boards | https://www.sparkfun.com/
 | DFRobot |  |  | $8.00 |  |  |  | Allowance; combine both modules; shipping resumes Oct 8 | https://www.dfrobot.com/product-3073.html
 | DigiKey + Mouser |  |  | $20.00 |  |  |  | Combined allowance for DigiKey passives/regulator and Mouser relay; neither is a destination quote | https://www.mouser.com/en/ProductDetail/Panasonic-Industry/TQ2-5V?qs=HLLy2pIPwutHaTSpVfb1kw%3D%3D
 | AutomationDirect |  |  | $0.00 |  |  |  | Advertised free shipping over $49; assumed eligible box/plate/glands basket | https://www.automationdirect.com/adc/shopping/catalog/enclosures_-a-_racks/miniature_cases/1554va2gy
 | Amazon / local / other |  |  | $10.00 |  |  |  | Allowance for Amazon/local/other purchases. Nilight advertises free continental-US shipping over $19.99; no additional lamp shipping included. | https://www.amazon.com/
Exact small parts · linked to the main basket; purchase quantities include spares.
Installed quantities match Rev E. Reused X1 costs $0. The separate 250-ohm test resistor is in the main basket.
References | Exact part number | Buy qty | Installed | Unit USD | Price basis | Lot USD | Vendor | Specification / notes | Source
R1, R2, R3, R4 | MFR-50FTE52-1K | 10 | 4 | $0.076 | Published | $0.76 | DigiKey | 1 kohm, 1%, 0.5 W axial; observed small-quantity / cut-tape price, 7 Oct 2026. | https://www.digikey.com/en/products/detail/yageo/MFR-50FTE52-1K/9147015
R5 | MFR-25FBF52-100K | 10 | 1 | $0.042 | Published | $0.42 | DigiKey | 100 kohm, 1%, 0.25 W axial; observed small-quantity / cut-tape price, 7 Oct 2026. | https://www.digikey.com/en/products/detail/yageo/MFR-25FBF52-100K/13473
D1, D2, D3, D4 | 1N4148 (onsemi) | 10 | 4 | $0.060 | Published | $0.60 | DigiKey | 1N4148 axial DO-35; band = cathode; observed small-quantity / cut-tape price, 7 Oct 2026. | https://www.digikey.com/en/products/detail/onsemi/1N4148/458603
C1, C5, C10, C11, C12 | C315C104K5R5TA | 10 | 5 | $0.488 | Published | $4.88 | DigiKey | 100 nF, 50 V, X7R, radial; observed small-quantity / cut-tape price, 7 Oct 2026. | https://www.digikey.com/en/products/detail/kemet/C315C104K5R5TA/12701330
C4 | SR305C334KARTR1 | 2 | 1 | $1.480 | Published | $2.96 | DigiKey | 330 nF, 50 V, X7R, radial; observed small-quantity / cut-tape price, 7 Oct 2026. | https://www.digikey.com/en/products/detail/kyocera-avx/SR305C334KARTR1/9948632
C7, C8, C9 | EEU-FC1V470B | 5 | 3 | $0.480 | Published | $2.40 | DigiKey | 47 uF, 35 V, 105 C, polarized radial; observed small-quantity / cut-tape price, 7 Oct 2026. | https://www.digikey.com/en/products/detail/panasonic-industry/EEU-FC1V470B/16639056
 |  |  |  |  | Lot total | $12.02 |  | Included once through E29. No extra fee or shipping added here.

Sheet: Options
Options · not included in Shopping total
Compare before buying. An alternative is not automatically a wiring-compatible substitute.
Type | Option | USD | Basis | Preference / limits | Source
Enclosure | Smaller Hammond 1554U2GY | $30.50 | Published; box only | 200 x 120 x 91 mm; consider only after measured two-level layout. Plate extra; smaller is harder to wire/service. | https://www.automationdirect.com/adc/shopping/catalog/enclosures_-a-_racks/miniature_cases/1554u2gy
Controller | Nano Every from Arduino USA | $12.90 | Published; shipping extra below threshold | Same exact ABX00028; $0.80 cheaper but separate shipping may cost more. | https://store-usa.arduino.cc/products/nano-every
Bench supply | FNIRSI DPS-150, without input adapter | $57.99 | Published; optional | CC/CV. Advertised DPS154 code subtracts $4 if accepted. Requires suitable higher-voltage DC/USB-C PD input; not an all-in-one AC supply. | https://www.fnirsi.com/products/dps-150
Bench supply | Jesverty SPS-3010 AC bench supply | $60.00 | Allowance only; Amazon price unverified | Simpler all-in-one option if 110/120 V US version is near $60. Adjustable CC/CV; 10 A rating is not the current-limit setting. | https://www.amazon.com/dp/B09YSJQWRG
Lamp drivers | MIKROE-6074 IPD Click TPD2015 | $29.00 | Published 4 Oct; out of stock at that review; excluded comparison only | Eight high-side channels, but not a drop-in: different interface, extra I/O hardware and watchdog/diagnostic redesign. Do not buy as a substitute. | https://www.mikroe.com/ipd-click-tpd2015
Valve command | DFRobot DFR0972 | $9.90 | Published comparison price observed 4 Oct; excluded option | Not selected: 18–24 V power requirement adds another converter to this nominal-12 V project. | https://www.dfrobot.com/product-3073.html
Tools | Temperature-controlled soldering iron kit | $35.00 | Allowance; only if not owned | Includes suitable tip/stand; buy electronics solder and flux, not plumbing acid flux. | https://www.amazon.com/s?k=temperature+controlled+soldering+iron+kit
Tools | Stripper, appropriate crimper and step bit | $30.00 | Allowance; only if not owned | Match crimper to chosen contacts/ferrules. Ordinary pliers do not replace the correct contact crimp tool. | https://www.amazon.com/s?k=wire+stripper+ferrule+crimper+step+drill+bit
Consumables | Electronics solder, flux and cleaning supplies | $15.00 | Allowance; only if not owned | Allow complete cleaning/drying before coating. Reuse existing suitable supplies. | https://www.amazon.com/s?k=electronics+solder+rosin+flux+isopropyl+alcohol
