aeae1/Rock-Saw-Water-Control/docs/assets/hardware/assembly-concept-rev-g-prompt.md

# Revision G assembly illustration

Created 8 October 2026 with the built-in image-generation tool, editing the existing Revision F concept. This is illustrative layout art. Module shapes, wire routing and plumbing details are not assembly instructions; the continuous vector schematic controls the electrical connections.

## Edit prompt

Use case: precise-object-edit. Edit target: the supplied existing assembly concept image. Preserve the photographic tabletop composition, exactly ten blue/white lamps, exactly three white Serial Wombat PCB0046 HSD boards, Arduino Nano Every, two red BOB-09118 input boards, DFR1229, SEN0262, and stainless blue-actuator valve and plumbing. This is illustrative component-layout art, NOT a precise wiring schematic.
Make only these Revision G changes:
1. Change subtitle to "Revision G • Arduino assembly concept".
2. Remove the black transistor and its two associated reset resistors from the small carrier immediately right of the Nano. Replace its annotation with "Internal watchdog • no external reset circuit".
3. Change the central board group subcaption to "20 lamp outputs • 4 spare". Third-board caption "Lamps 9–10".
4. Remove the round machine connector and its braided cable at left. Show five separate incoming wire stubs from the left edge clearly labeled in vertical order "12 V", "0 V", "J", "H", "G", red black then three different signal colors, routing toward the input/power area. No harness block.
5. Bottom caption "ASSEMBLY CONCEPT • Use the Revision G schematic for wiring • Component appearance and fittings illustrative".
No flow meter, relay or temperature sensor. Electrical wires terminate at electronics and the actuator housing, never at pipes, hose, fittings or steel valve body. Preserve remaining layout and labels.
