aeae1/Rock-Saw-Water-Control/docs/assets/hardware/assembly-concept-rev-f-prompt.md

# Revision F assembly illustration

Generated 8 October 2026 by editing the Revision E assembly concept. This is AI-generated component/layout concept art, not terminal-level wiring documentation. The formal schematic is authoritative.

Requested changes: retain ten blue/white lamps, three PCB0046 HSD boards, Nano Every, two input boards, DFR1229, SEN0262 and the five-wire proportional actuator. Remove the signal relay and dedicated regulator. Show a small transistor and two resistors on the existing Nano carrier, with a reserved Wombat output returning to the host reset circuit. Valve power shares the machine supply; command and feedback connect directly. Group machine power, return and G/H/J on the left. Preserve the manual shutoff, strainer and hose route. No flow meter or temperature probes.

Component shapes, lead routing, connector appearances and fittings are illustrative. Use [the continuous Revision F PDF](water-controller-single-page-rev-f.pdf) for the complete wire-by-wire circuit. The original machine artwork in the README banner was not edited.
