aeae1/Rock-Saw-Water-Control/docs/assets/hardware/assembly-concept-rev-e-prompt.md

# Revision E assembly illustration provenance

Tool: built-in image generation, local reference image edit.

Reference: `assembly-concept-rev-d.png`. Output: `assembly-concept-rev-e.png`.

The physical layout is illustrative. Use the Revision E schematic and connection schedule for wiring; this image does not specify terminal positions or exact pipe fittings.

## Editing instruction

Use case: precise-object-edit. Asset: realistic assembly illustration for the existing Rock-Saw-Water-Control repository README. Edit the supplied Revision D image into Revision E. Preserve this exact clean photographic tabletop illustration style, component positions, ten blue/white lamps numbered 1–10, three Serial Wombat HSD boards, Arduino Nano Every, two red optoisolator boards, DFR1229 command board, SEN0262 position-feedback board, valve power/signal-disconnect relay/regulator board, reused 14-pin connector, G/H rocker and J trigger inset, manual shutoff, strainer and stainless proportional valve. REMOVE the black SciOSense flow meter, its blue top, its electrical cable including red/yellow/black wires along the plumbing, and the entire 'SciOSense UFM-02-03NP4 5 V flow meter' label. Replace that meter and its two white adapter fittings with a simple continuous plain metal plumbing connection from the cleanable strainer toward the existing proportional valve; no sensor or wires touching this plumbing. No temperature probes or extra sensors. The five-wire valve cable still enters the actuator's blue top housing, never the metal valve body or hose. Do not change other equipment. Change the subtitle to 'Revision E • Arduino assembly concept'. Change bottom footnote to 'ASSEMBLY CONCEPT • Use the Revision E schematic for wiring • Component appearance and fittings illustrative'. Keep the title and other labels, crisp and readable. The output is an illustrative assembly layout, NOT a pin-accurate wiring diagram. Wide high resolution. Do not add connectors, fuse holders, modules, or extra wires.
