aeae1/Rock-Saw-Water-Control/docs/assets/hardware/assembly-concept-rev-d-prompt.md

# Revision D assembly illustration provenance

Tool: built-in image generation, local reference image edit.

Reference: `assembly-concept-rev-c.png`. Output: `assembly-concept-rev-d.png`.

The physical layout is illustrative; use the Revision D schematic for connections.

## Editing instruction

Edit the supplied realistic assembly illustration. Preserve the exact layout, style, title, all ten lamps numbered 1–10, all three Serial Wombat HSD boards, Nano, two red opto boards, green command and feedback modules, relay/regulator board, connector, joystick inset, valve and all plumbing. Remove the two gold-tipped DS18B20 temperature probes located between the lower wire loom and green modules, remove their slim black probe cables, remove the arrow and entire '2 × DS18B20 temperature sensors' caption. Restore a clean pale tabletop in that space. Do not add sensors anywhere. Change 'Revision C' to 'Revision D' in the subtitle and bottom footnote. Keep the footnote prominent: 'ASSEMBLY CONCEPT • Use the Revision D schematic for wiring • Component appearance and fittings illustrative'. Keep other labeling exactly. This is an illustrative physical layout, not a pin-accurate circuit diagram; do not add new wires or devices. High resolution landscape output.
