aeae1/Rock-Saw-Water-Control/docs/assets/hardware/assembly-concept-arduino-prebuilt.png

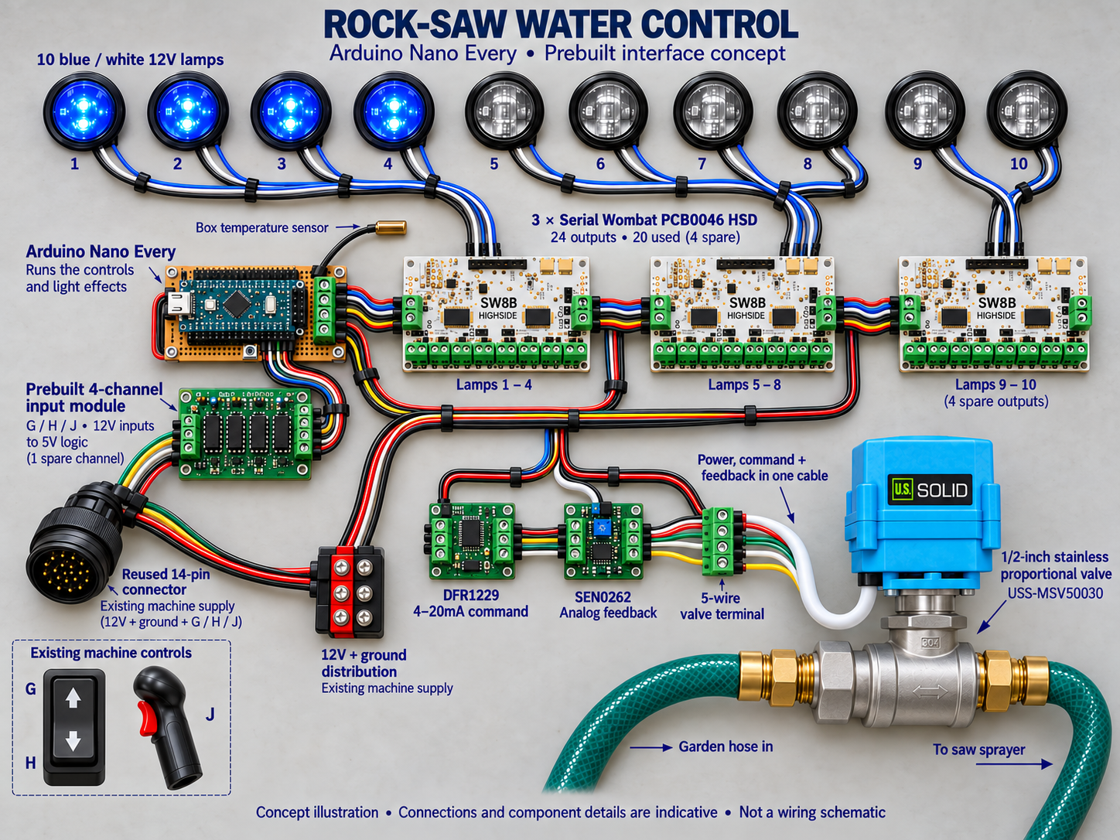
docs/assets/hardware/assembly-concept-arduino-prebuilt.png
