aeae1/Rock-Saw-Water-Control/docs/assets/hardware/assembly-concept-rev-c.png

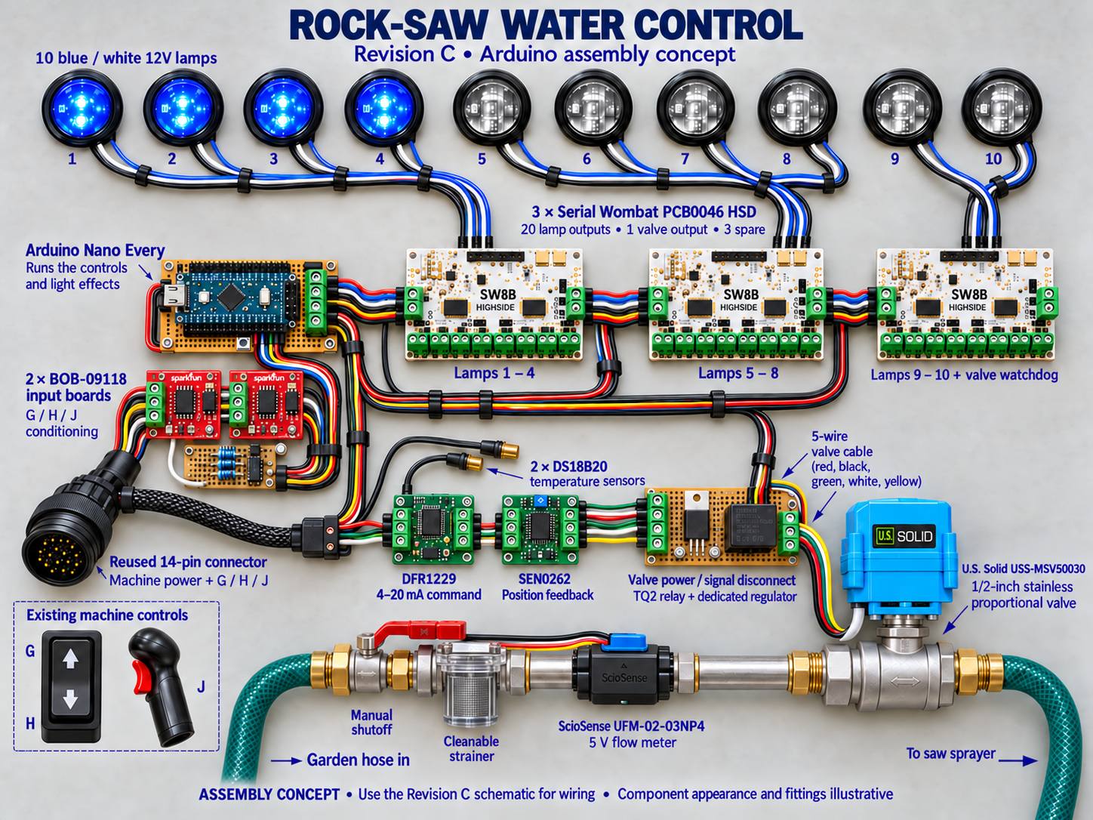
docs/assets/hardware/assembly-concept-rev-c.png
