aeae1/Rock-Saw-Water-Control/docs/assets/hardware/assembly-concept-rev-e.png

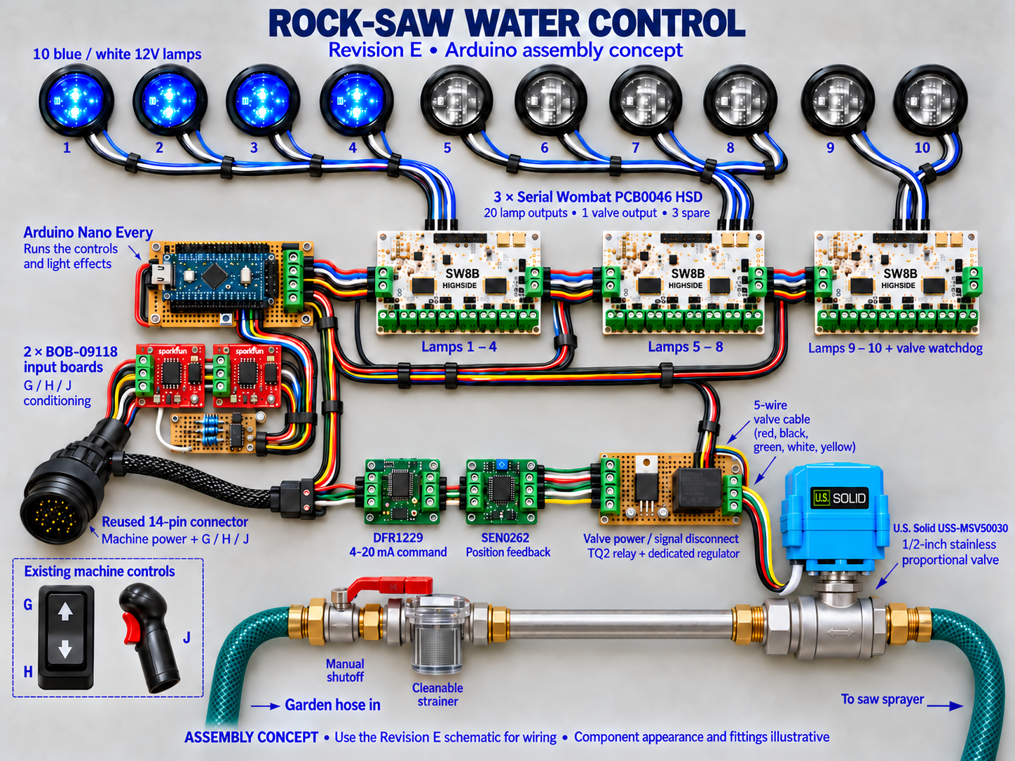
docs/assets/hardware/assembly-concept-rev-e.png
