aeae1/Rock-Saw-Water-Control/docs/assets/hardware/assembly-concept-rev-g.png

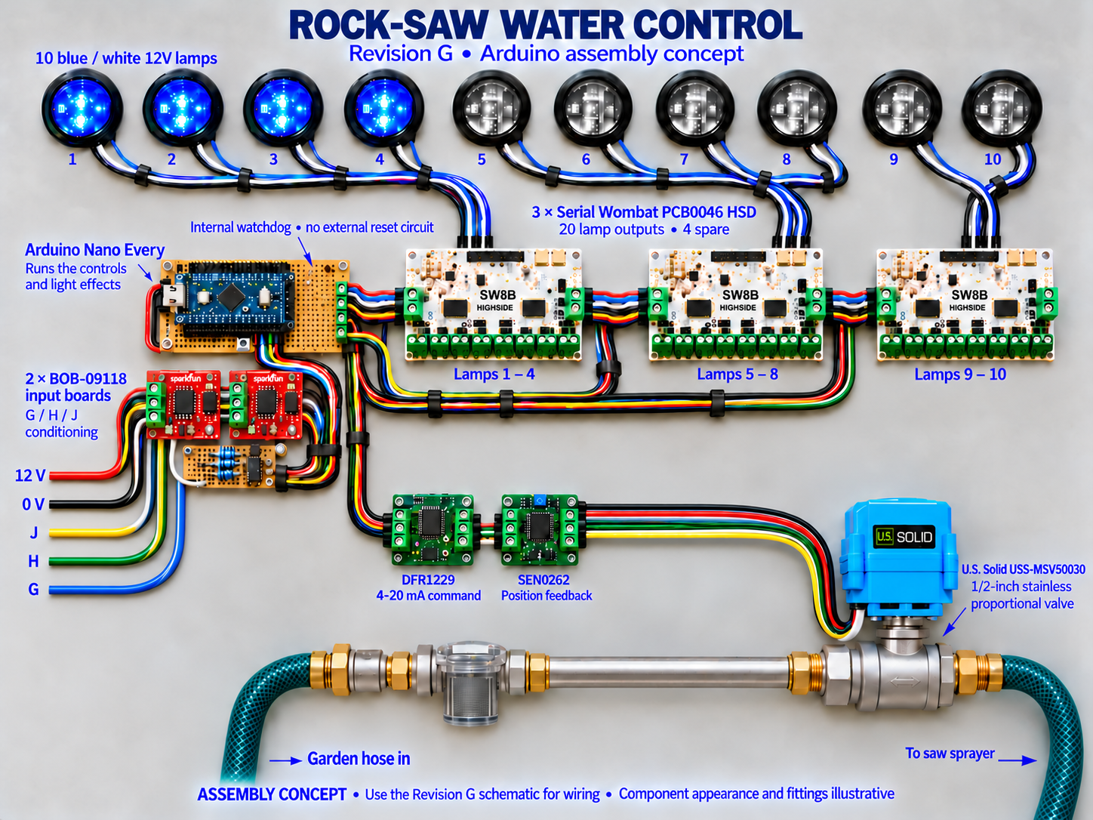
docs/assets/hardware/assembly-concept-rev-g.png
