aeae1/Rock-Saw-Water-Control/docs/assets/hardware/water-controller-wiring-flow.png

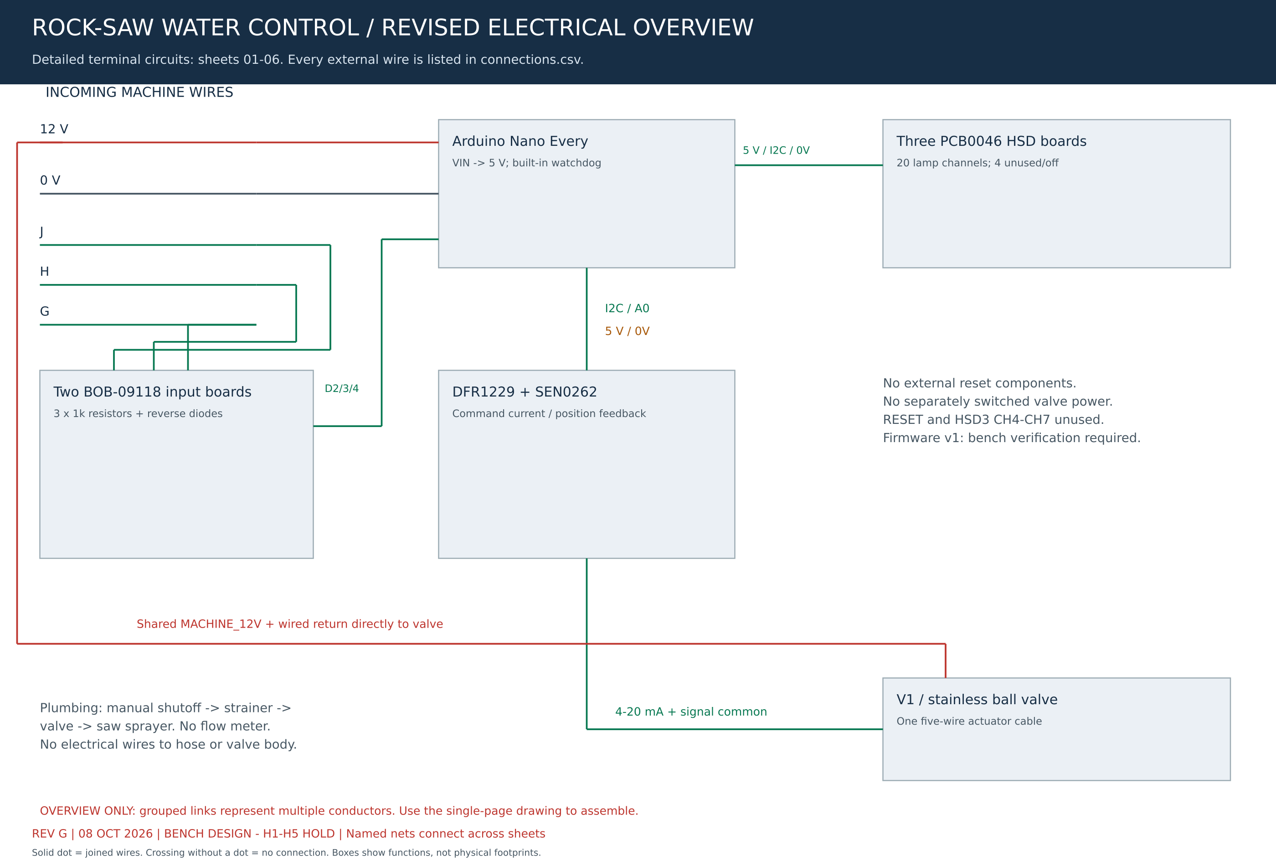
docs/assets/hardware/water-controller-wiring-flow.png
