aeae1/Rock-Saw-Water-Control/(commit log)

2026-10-01 Add water-control simulator, engineering documentation, and original-art banner
    [bom.csv]
2026-10-01 Expand edge-case and browser tests; document controls and use 1.5-second setup hold
2026-10-01 Document Tuya control feasibility and wired proportional valve alternative
    [bom.csv]
2026-10-01 Price half-inch valve options and simplify simulator navigation
    [bom.csv]
2026-10-01 Harden control recovery and document Normal, Set Max, Flush and hardware build
    Prevent aborted holds from toggling water, give closing and startup recovery priority, and exit Flush on a fresh press. Add ten latched fault previews with neutral-input acknowledgement, J reset and stuck-trigger detection.
    Expand deterministic and browser regression coverage. Rewrite operator instructions, improve the rear-trigger illustration, correct attribution, and add sourced valve, lamp-switch, enclosure and flow-calibration plans.
    [bom.csv]
2026-10-01 Specify interchangeable dual-color lamps and verify Nilight wiring
    [bom.csv]
2026-10-03 Audit startup and recovery; reconcile current hardware plan
    Track operator inputs while commands are inhibited, require stable neutral at startup, cancel reset holds on rocker movement, and enforce stuck-trigger deadlines despite delayed callbacks.
    Add exhaustive remapping and fault-pair coverage, expand browser regressions, validate documentation links, and publish the assembly illustration with the current Arduino/prebuilt-board design and explicit hardware acceptance gaps.
    [bom.csv]
2026-10-04 Audit electrical connections and document Rev C bench schematic
    Add six circuit sheets, a 24-page audit, 138-connection schedule, exact circuit values, and explicit physical release holds. Specify conditioned inputs, valve-power watchdog and signal relay, flow/temperature sensing, recovery sequencing and fault-logging limits.
    Add 18 wiring checks including destructive-connection mutations. Reconcile the README, build guide, parts list and firmware contract. No hardware-ready firmware or field qualification is claimed.
    [bom.csv, connections.csv]
2026-10-04 Add priced procurement plan, enclosure options and battery bench guidance
    [bom.csv, shopping-list.xlsx]
2026-10-05 Define safe fault closing and recovery; publish current circuit drawings
2026-10-07 Remove external temperature sensing and publish complete single-page Revision D schematic
    Update the realistic README assembly illustration, schematic, netlist and shopping documents. Reserve fault 9 without renumbering stuck J, retain built-in driver thermal protection, and verify the temperature-branch-only wiring change. Local validation: 225 deterministic tests and schematic/export checks pass.
    [bom.csv, connections.csv, shopping-list.xlsx]
2026-10-07 Draw continuous overall wiring and refresh component purchasing list
    [bom.csv, shopping-list.xlsx]
2026-10-07 Remove permanent flow meter in Revision E and document power-off input behavior
    [bom.csv, connections.csv, shopping-list.xlsx]
2026-10-08 Rev F: simplify valve wiring and add continuous left-entry schematic
    Remove the signal relay and coil regulator. Keep command/feedback modules and three Wombat drivers; use the reserved watchdog output for a transistor-driven host reset. Group machine power, ground and G/H/J at the left of the 108-wire overall sheet.
    Update the detailed booklet, assembly illustration, Markdown purchasing list and physical fault-response limits. Add reset wiring mutation tests and raster export validation. Local verification: 230 tests passed; 193 documentation links and all 41 component references checked. Physical bench qualification and flashable firmware remain outstanding.
    [bom.csv, connections.csv, shopping-list-rev-e.xlsx]
2026-10-08 Add Revision G wiring and Nano Every firmware v1 bench release
    [bom.csv, connections.csv]
2026-10-08 Add corrected assembly views to README
